colonelblacc/Automotive-BLE-CAN-Gateway/BOM/BOM_Automotive_BLE_CAN.csv

Item | Designator | Qty | Value | Description | Package | Manufacturer | MPN | Ratings / Tolerance | Automotive Qual | Alternatives | Notes / Design Intent
1 | AE1 | 1 | Antenna_Chip | 2.45 GHz Ceramic Chip Antenna, Peak Gain 1.5 dBi, 50 Ohm | Johanson_2450AT18x100_2400-2500Mhz | Johanson Technology | 2450AT18D0100E |  | AEC-Q200 qualified option | Pulse W3008, Taoglas GLA.01 | Compact Bluetooth Low Energy omnidirectional antenna
2 | C1 | 1 | 2.2uF | 2.2uF Ceramic Capacitor, Decoupling | C_0603_1608Metric | Murata / TDK / Taiyo Yuden | GCM188R71E2.2K | 16V / 25V, X7R, ±10% | AEC-Q200 Grade 1
3 | C2 | 1 | 2.2nF | 2.2nF Ceramic Capacitor, Precision / High-Q | C_0603_1608Metric | Murata / TDK / Taiyo Yuden | GCM1885C1H2.2nFA01D | 50V, C0G/NP0 (RF) or X7R, ±5% | AEC-Q200 Grade 1
4 | C3, C53 | 2 | 22uF | 22uF Ceramic Capacitor, High Capacitance Low ESR | C_0603_1608Metric | Murata / TDK / Taiyo Yuden | GCM21BR71E226KA73L | 25V / 50V, X7R / X7S, ±10% | AEC-Q200 Grade 1
5 | C4, C30, C31, C34, C37, C46, C50, C52 | 8 | 100nF | 100nF Ceramic Capacitor, Precision / High-Q | C_0603_1608Metric | Murata / TDK / Taiyo Yuden | GCM1885C1H100nFA01D | 50V, C0G/NP0 (RF) or X7R, ±5% | AEC-Q200 Grade 1
6 | C5, C6, C7, C8, C9, C10, C11, C16 | 8 | 0.1uF | 0.1uF Ceramic Capacitor, Decoupling | C_0603_1608Metric | Murata / TDK / Taiyo Yuden | GCM188R71E0.1K | 16V / 25V, X7R, ±10% | AEC-Q200 Grade 1
7 | C12 | 1 | 10uF | 10uF Ceramic Capacitor, High Capacitance Low ESR | C_0603_1608Metric | Murata / TDK / Taiyo Yuden | GCM21BR71E106KA73L | 25V / 50V, X7R / X7S, ±10% | AEC-Q200 Grade 1
8 | C13, C33, C42, C43, C45, C51 | 6 | 1uF | 1uF Ceramic Capacitor, Decoupling | C_0603_1608Metric | Murata / TDK / Taiyo Yuden | GCM188R71E1K | 16V / 25V, X7R, ±10% | AEC-Q200 Grade 1
9 | C14, C17 | 2 | 12pF | 12pF Ceramic Capacitor, Precision / High-Q | C_0402_1005Metric | Murata / TDK / Taiyo Yuden | GCM1555C1H12pFA01D | 50V, C0G/NP0 (RF) or X7R, ±5% | AEC-Q200 Grade 1
10 | C15 | 1 | 10pF | 10pF Ceramic Capacitor, Precision / High-Q | C_0402_1005Metric | Murata / TDK / Taiyo Yuden | GCM1555C1H10pFA01D | 50V, C0G/NP0 (RF) or X7R, ±5% | AEC-Q200 Grade 1
11 | C18, C20 | 2 | 15pF | 15pF Ceramic Capacitor, Precision / High-Q | C_0402_1005Metric | Murata / TDK / Taiyo Yuden | GCM1555C1H15pFA01D | 50V, C0G/NP0 (RF) or X7R, ±5% | AEC-Q200 Grade 1
12 | C19 | 1 | 1.2pF | 1.2pF Ceramic Capacitor, Precision / High-Q | C_0402_1005Metric | Murata / TDK / Taiyo Yuden | GCM1555C1H1.2pFA01D | 50V, C0G/NP0 (RF) or X7R, ±5% | AEC-Q200 Grade 1
13 | C21 | 1 | 0.7pF | 0.7pF Ceramic Capacitor, Precision / High-Q | C_0402_1005Metric | Murata / TDK / Taiyo Yuden | GCM1555C1H0.7pFA01D | 50V, C0G/NP0 (RF) or X7R, ±5% | AEC-Q200 Grade 1
14 | C22, C23 | 2 | 1.5pF | 1.5pF Ceramic Capacitor, Precision / High-Q | C_0402_1005Metric | Murata / TDK / Taiyo Yuden | GCM1555C1H1.5pFA01D | 50V, C0G/NP0 (RF) or X7R, ±5% | AEC-Q200 Grade 1
15 | C24 | 1 | 100nF | 100nF Ceramic Capacitor, Precision / High-Q | C_0402_1005Metric | Murata / TDK / Taiyo Yuden | GCM1555C1H100nFA01D | 50V, C0G/NP0 (RF) or X7R, ±5% | AEC-Q200 Grade 1
16 | C25 | 1 | 330nF | 330nF Ceramic Capacitor, Precision / High-Q | C_0603_1608Metric | Murata / TDK / Taiyo Yuden | GCM1885C1H330nFA01D | 50V, C0G/NP0 (RF) or X7R, ±5% | AEC-Q200 Grade 1
17 | C27, C28 | 2 | 8.2pF | 8.2pF Ceramic Capacitor, Precision / High-Q | C_0402_1005Metric | Murata / TDK / Taiyo Yuden | GCM1555C1H8.2pFA01D | 50V, C0G/NP0 (RF) or X7R, ±5% | AEC-Q200 Grade 1
18 | C29 | 1 | 10uF | 10uF Ceramic Capacitor, High Capacitance Low ESR | C_1210_3225Metric | Murata / TDK / Taiyo Yuden | GCM21BR71E106KA73L | 25V / 50V, X7R / X7S, ±10% | AEC-Q200 Grade 1
19 | C32 | 1 | 4.7nF | 4.7nF Ceramic Capacitor, Precision / High-Q | C_0603_1608Metric | Murata / TDK / Taiyo Yuden | GCM1885C1H4.7nFA01D | 50V, C0G/NP0 (RF) or X7R, ±5% | AEC-Q200 Grade 1
20 | C35, C40 | 2 | 22uF | 22uF Ceramic Capacitor, High Capacitance Low ESR | C_0805_2012Metric | Murata / TDK / Taiyo Yuden | GCM21BR71E226KA73L | 25V / 50V, X7R / X7S, ±10% | AEC-Q200 Grade 1
21 | C36, C49 | 2 | 2.2uF | 2.2uF Ceramic Capacitor, Decoupling | C_0805_2012Metric | Murata / TDK / Taiyo Yuden | GCM188R71E2.2K | 16V / 25V, X7R, ±10% | AEC-Q200 Grade 1
22 | C38, C39 | 2 | 4.7uF | 4.7uF Ceramic Capacitor, Decoupling | C_0805_2012Metric | Murata / TDK / Taiyo Yuden | GCM188R71E4.7K | 16V / 25V, X7R, ±10% | AEC-Q200 Grade 1
23 | C26, C41, C44 | 3 | 10uF | 10uF Ceramic Capacitor, High Capacitance Low ESR | C_0805_2012Metric | Murata / TDK / Taiyo Yuden | GCM21BR71E106KA73L | 25V / 50V, X7R / X7S, ±10% | AEC-Q200 Grade 1
24 | C47 | 1 | 1.0nF | 1.0nF Ceramic Capacitor, Precision / High-Q | C_0603_1608Metric | Murata / TDK / Taiyo Yuden | GCM1885C1H1.0nFA01D | 50V, C0G/NP0 (RF) or X7R, ±5% | AEC-Q200 Grade 1
25 | C48 | 1 | 100pF | 100pF Ceramic Capacitor, Precision / High-Q | C_0402_1005Metric | Murata / TDK / Taiyo Yuden | GCM1555C1H100pFA01D | 50V, C0G/NP0 (RF) or X7R, ±5% | AEC-Q200 Grade 1
26 | D1 | 1 | D_TVS | 36V Bidirectional Automotive TVS Diode, 400W Peak Pulse Power | D_SMC | Bourns / Littelfuse | SMAJ36CA |  | AEC-Q101, ISO 7637-2 / ISO 16750-2 | TPSMAJ36CA | Primary vehicle input transient & load-dump surge protection
27 | D2 | 1 | 15V | 15V 500mW Zener Diode | D_SOD-123 | Diodes Inc | BZT52C15-7-F |  | AEC-Q101 | MMSZ5245B | P-FET gate clamp protection against over-voltage
28 | D3 | 1 | D_TVS | 70V 70mA Dual Schottky Barrier Diode | D_0402_1005Metric | Vishay | BAS70-04 |  | AEC-Q101 | BAT54S | Fast clamp steering diode
29 | D4 | 1 | LED | 70V 70mA Dual Schottky Barrier Diode | LED_0603_1608Metric | Vishay | BAS70-04 |  | AEC-Q101 | BAT54S | Fast clamp steering diode
30 | D5 | 1 | D_TVS_Dual_AAC | Automotive Dual Bidirectional Transil ESD Protection for CAN bus | SOT-23 | STMicroelectronics | ESDCAN24-2BWY |  | AEC-Q101, ISO 10605 (±30kV air/contact) | NUP2105L, PESD2CAN | Protects TCAN4550 CANH/CANL pins against ESD & automotive spikes
31 | F1 | 1 | 2A (provisional) | 2.0A, 125V Fast-Acting Surface Mount Fuse | Fuse_1206_3216Metric | Littelfuse | 0451002.MRL |  | AEC-Q200 | 0154002.DR, CC12H2A | Vehicle input catastrophic overcurrent fuse
32 | FL1 | 1 | Filter_EMI_CommonMode | Automotive Common-Mode Choke 51uH for CAN-Bus / CAN FD | L_CommonModeChoke_Coilcraft_1812CAN | TDK | ACT45B-510-2P-TL003 |  | AEC-Q200 Grade 1 | DLW43SH510XK2L | Filters common-mode RF noise and emissions on CAN bus (CISPR 25)
33 | J1, J2 | 2 | Conn_01x03_Pin | 3-pin 3.5mm Automotive Screw Terminal (VIN, GND, IGN) | PinHeader_1x03_P2.54mm_Vertical | Phoenix Contact / JST / Wurth | Phoenix Contact 1984620 (PT 1.5/3-3.5-H) |  | Automotive / High Temp UL94V-0
34 | J3 | 1 | Conn_01x05_Pin | 5-pin Micro SWD Debug & Programming Header (1.27mm) | PinHeader_1x05_P2.54mm_Vertical | Phoenix Contact / JST / Wurth | Samtec FTSH-105-01-L-DV |  | Automotive / High Temp UL94V-0
35 | J_BAT1 | 1 | Conn_01x03_Pin | 2-pin JST-PH 2.0mm Shrouded Battery Connector | JST_PH_B3B-PH-K_1x03_P2.00mm_Vertical | Phoenix Contact / JST / Wurth | JST S2B-PH-K-S |  | Automotive / High Temp UL94V-0
36 | JP1 | 1 | Conn_01x02_Pin | 2-pin 2.54mm Header with Jumper Shunt (120 Ohm CAN Termination) | PinHeader_1x02_P2.54mm_Vertical | Harwin / Samtec | M20-9990245 |  | AEC-Q200 / Industrial
37 | L1 | 1 | 47uH | 22uH Shielded Power Inductor for LM5164 Buck | L_Bourns_SRN6045TA | Coilcraft / TDK / Würth | XAL5030-223MEB (22uH, 2.1A) | High Saturation Current, Shielded | AEC-Q200 Grade 1
38 | L2 | 1 | 10uH | 10uH Power Inductor / RF Choke | L_0805_2012Metric | Coilcraft / TDK / Würth | LQW15AN10uH | High Saturation Current, Shielded | AEC-Q200 Grade 1
39 | L3 | 1 | 2nH | 2nH Power Inductor / RF Choke | L_0402_1005Metric | Coilcraft / TDK / Würth | LQW15AN2nH | High Saturation Current, Shielded | AEC-Q200 Grade 1
40 | L4 | 1 | 2.8nH | 2.8nH Power Inductor / RF Choke | L_0402_1005Metric | Coilcraft / TDK / Würth | LQW15AN2.8nH | High Saturation Current, Shielded | AEC-Q200 Grade 1
41 | L6 | 1 | 2.2uH | 2.2uH Shielded Power Inductor for TPS63900 Buck-Boost | L_1008_2520Metric | Coilcraft / TDK / Würth | XFL4020-222MEB (2.2uH, 3.5A) | High Saturation Current, Shielded | AEC-Q200 Grade 1
42 | L5, L8 | 2 | 6.8uH | 4.7uH Shielded Power Inductor for LMR36506 Buck | L_Coilcraft_XxL4020 | Coilcraft / TDK / Würth | LPS4018-472MRB (4.7uH, 1.8A) | High Saturation Current, Shielded | AEC-Q200 Grade 1
43 | Q1 | 1 | SQ2361AEES-T1_GE3 | -60V, -2.1A P-Channel TrenchFET Power MOSFET | SOT-23 | Vishay Siliconix | SQ2361AEES-T1_GE3 |  | AEC-Q101 Grade 1 (-55 to 175C) | DMP6023L, SI2319CDS | Low-loss reverse battery polarity protection
44 | R3 | 1 | 174k | 174k Thick Film Precision Resistor | R_0603_1608Metric | Vishay / Yageo / Panasonic | CRCW0603174kFKTA | 1/10W, 1%, ±100ppm/°C | AEC-Q200 Grade 1
45 | R6 | 1 | 20.0k | 20.0k Thick Film Precision Resistor | R_0603_1608Metric | Vishay / Yageo / Panasonic | CRCW060320R0kFKTA | 1/10W, 1%, ±100ppm/°C | AEC-Q200 Grade 1
46 | R1, R2, R4, R5, R7 | 5 | 100k | 100k Thick Film Precision Resistor | R_0603_1608Metric | Vishay / Yageo / Panasonic | CRCW0603100kFKTA | 1/10W, 1%, ±100ppm/°C | AEC-Q200 Grade 1
47 | R11, R12 | 2 | 60.4 | 60.4 Thick Film Precision Resistor | R_0805_2012Metric | Vishay / Yageo / Panasonic | CRCW040260R4FKED | 1/10W, 1%, ±100ppm/°C | AEC-Q200 Grade 1
48 | R13, R14 | 2 | 1M | 1M Thick Film Precision Resistor | R_0603_1608Metric | Vishay / Yageo / Panasonic | CRCW06031MFKTA | 1/10W, 1%, ±100ppm/°C | AEC-Q200 Grade 1
49 | R15 | 1 | 2.16k | 2.16k Thick Film Precision Resistor | R_0603_1608Metric | Vishay / Yageo / Panasonic | CRCW06032R16kFKTA | 1/10W, 1%, ±100ppm/°C | AEC-Q200 Grade 1
50 | R16 | 1 | 2k | 2k Thick Film Precision Resistor | R_0603_1608Metric | Vishay / Yageo / Panasonic | CRCW06032kFKTA | 1/10W, 1%, ±100ppm/°C | AEC-Q200 Grade 1
51 | R17 | 1 | 16.2k | 16.2k Thick Film Precision Resistor | R_0603_1608Metric | Vishay / Yageo / Panasonic | CRCW060316R2kFKTA | 1/10W, 1%, ±100ppm/°C | AEC-Q200 Grade 1
52 | R18 | 1 | 511 | 511 Thick Film Precision Resistor | R_0603_1608Metric | Vishay / Yageo / Panasonic | CRCW0603511FKTA | 1/10W, 1%, ±100ppm/°C | AEC-Q200 Grade 1
53 | R19 | 1 | 36.5k | 36.5k Thick Film Precision Resistor | R_0603_1608Metric | Vishay / Yageo / Panasonic | CRCW060336R5kFKTA | 1/10W, 1%, ±100ppm/°C | AEC-Q200 Grade 1
54 | R20 | 1 | 9.53k | 9.53k Thick Film Precision Resistor | R_0603_1608Metric | Vishay / Yageo / Panasonic | CRCW06039R53kFKTA | 1/10W, 1%, ±100ppm/°C | AEC-Q200 Grade 1
55 | R21 | 1 | 5k | 5k Thick Film Precision Resistor | R_0603_1608Metric | Vishay / Yageo / Panasonic | CRCW06035kFKTA | 1/10W, 1%, ±100ppm/°C | AEC-Q200 Grade 1
56 | R22, R25 | 2 | 1k | 1k Thick Film Precision Resistor | R_0603_1608Metric | Vishay / Yageo / Panasonic | CRCW06031kFKTA | 1/10W, 1%, ±100ppm/°C | AEC-Q200 Grade 1
57 | R23 | 1 | 110k | 110k Thick Film Precision Resistor | R_0603_1608Metric | Vishay / Yageo / Panasonic | CRCW0603110kFKTA | 1/10W, 1%, ±100ppm/°C | AEC-Q200 Grade 1
58 | R8, R9, R10, R24 | 4 | 10k | 10k Thick Film Precision Resistor | R_0603_1608Metric | Vishay / Yageo / Panasonic | CRCW060310kFKTA | 1/10W, 1%, ±100ppm/°C | AEC-Q200 Grade 1
59 | R26 | 1 | 402k | 402k Thick Film Precision Resistor | R_0603_1608Metric | Vishay / Yageo / Panasonic | CRCW0603402kFKTA | 1/10W, 1%, ±100ppm/°C | AEC-Q200 Grade 1
60 | R27 | 1 | 20k | 20k Thick Film Precision Resistor | R_0805_2012Metric | Vishay / Yageo / Panasonic | CRCW040220kFKED | 1/10W, 1%, ±100ppm/°C | AEC-Q200 Grade 1
61 | R28 | 1 | 100k | 100k Thick Film Precision Resistor | R_0805_2012Metric | Vishay / Yageo / Panasonic | CRCW0402100kFKED | 1/10W, 1%, ±100ppm/°C | AEC-Q200 Grade 1
62 | TP1, TP2, TP3, TP4, TP5, TP6, TP7, TP8, TP9 | 9 | TestPoint | SMD Test Point Pad (TestPoint) | TestPoint_Pad_D2.0mm | Keystone Electronics | 5015 / 5019 | Gold Plated | RoHS / Commercial
63 | U1 | 1 | LM5164DDA | 100V, 1A Synchronous COT Step-Down Converter | HSOP-8-1EP_3.9x4.9mm_P1.27mm_EP2.41x3.1mm_ThermalVias | Texas Instruments | LM5164DDAR |  | AEC-Q100 Grade 1 | LMR16006, TPS54160 | Primary vehicle buck 9-36V to 3.3V
64 | U2 | 1 | CC2340R52E0RKPR | SimpleLink Multiprotocol 2.4 GHz BLE 5.3 Wireless MCU, 512KB Flash, Cortex-M0+ | RKP0040B-MFG | Texas Instruments | CC2340R40RKPR |  | AEC-Q100 (CC2340R5-Q1) | NRF52840, EFR32BG22 | Main BLE communication & system controller
65 | U3 | 1 | TCAN4550RGY | Automotive CAN FD Controller with Integrated Transceiver, SPI Interface | Texas_RGY_R-PVQFN-N20_EP2.05x3.05mm | Texas Instruments | TCAN4550RGYRQ1 |  | AEC-Q100 Grade 1 | TCAN4551-Q1, MCP2518FD | ISO 11898-2:2016 CAN FD physical layer & protocol engine
66 | U4 | 1 | LMR36506MSC5RPERQ1 | 65V, 0.6A Synchronous Step-Down Buck Converter (5V Output) | RPE0009A | Texas Instruments | LMR36506MSC5RPERQ1 |  | AEC-Q100 Grade 1 | LMR33610-Q1 | Secondary buck for CAN transceiver & charger
67 | U5 | 1 | BQ24040DSQR | 1A Single-Input, Single-Cell Li-Ion Battery Charger with NTC & Power Good | DSQ10_P9X1P5 | Texas Instruments | BQ24040DSQR |  | Standard Industrial (-40 to 125C) | MCP73831, BQ24090 | Backup Li-Ion cell charging from 5V rail
68 | U6 | 1 | TPS63900 | High-Efficiency 1.8V-5.5V, 400mA Buck-Boost Converter with Dynamic Voltage Scaling | WSON-10-1EP_2.5x2.5mm_P0.5mm_EP1.2x2mm_ThermalVias | Texas Instruments | TPS63900DSKR |  | Standard Industrial (-40 to 125C) | ISL9120, TPS63000 | Regulates 3.0-4.2V battery to constant 3.3V backup
69 | U7 | 1 | TPS2116DRLR | Low-IQ, 1.6V to 5.5V, 2.5A Dual-Input Power Multiplexer with Auto-Switchover | DRL0008A-MFG | Texas Instruments | TPS2116DRLR |  | Standard Industrial (-40 to 125C) | TPS2113A, TPS2121 | Seamless auto-switch between vehicle 3.3V and battery 3.3V
70 | U8 | 1 | LMR36506MSCQRPERQ1 | 65V, 0.6A Synchronous Step-Down Buck Converter (5V Output) | RPE0009A | Texas Instruments | LMR36506MSC5RPERQ1 |  | AEC-Q100 Grade 1 | LMR33610-Q1 | Dedicated 5V power supply rail
71 | Y1 | 1 | 48MHz | 48.000 MHz SMD Crystal, 8pF, ±10ppm | Crystal_SMD_2016-4Pin_2.0x1.6mm | NDK | NX2016SA-48M-STD-CSZ-1 |  | AEC-Q200 Grade 1 | Abracon ABM11W-48.0000MHZ | CC2340 48 MHz main system & RF oscillator
72 | Y2 | 1 | 32.768Khz | 32.768 kHz Tuning Fork Crystal, 12.5pF, ±20ppm | Crystal_SMD_3215-2Pin_3.2x1.5mm | Abracon | AB26T-32.768KHZ |  | AEC-Q200 | Citizen CMR200T | Real-Time Clock / low-power sleep timer
73 | Y3 | 1 | 40MHz | 40.000 MHz Automotive SMD Crystal, 10pF, ±30ppm | Crystal_SMD_3225-4Pin_3.2x2.5mm | Epson | FA-238 40.0000MB-C3 |  | AEC-Q200 Grade 1 | TXC 7A-40.000MAAJ-T | TCAN4550 CAN FD bit-rate generator clock source
