colonelblacc/Automotive-BLE-CAN-Gateway/Step Files/Automotive_BLE_CAN.step

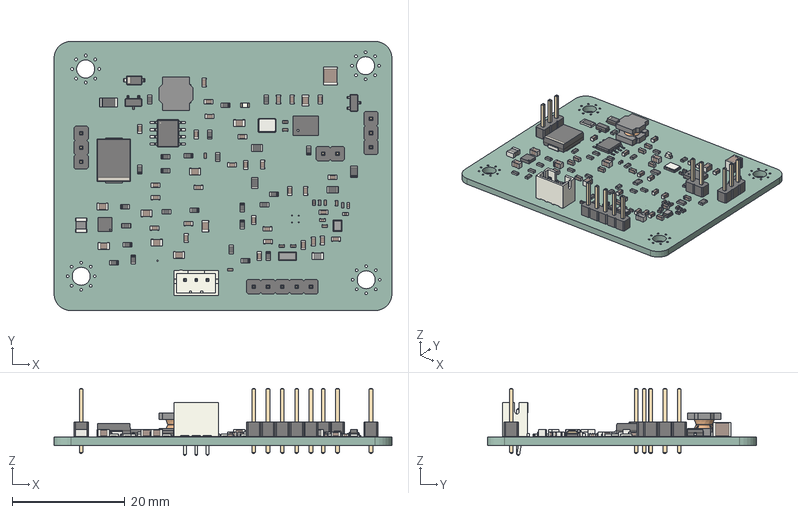
[picture p15: CAD file, 2026-10-16]
Step Files/Automotive_BLE_CAN.step
59.9 x 47.8 x 11.9 mm
HSOP-8-1EP_3.9x4.9mm_P1.27mm_EP2.41x3.1mm
C_0603_1608Metric x 30
C_0402_1005Metric x 13
C_0805_2012Metric x 9
R_0603_1608Metric x 24
D_SOD-123
Crystal_SMD_3225-4Pin_3.2x2.5mm
7a0a93aa-926b-11ed-8620-a0cec80452fd_part
7a0a9878-926b-11ed-8620-a0cec80452fd_part
7a0a9b48-926b-11ed-8620-a0cec80452fd_part
7a0a9db4-926b-11ed-8620-a0cec80452fd_part
R_0805_2012Metric x 4
Crystal_SMD_3215-2Pin_3.2x1.5mm
43e594cd-ed20-11ed-b06b-f76ff2fea4fd_part
43e594ce-ed20-11ed-b06b-f76ff2fea4fd_part
43e594cf-ed20-11ed-b06b-f76ff2fea4fd_part
JST_B3B_PH_K
PinHeader_1x03_P254mm_Vertical x 2
SOT-23 x 2
PinHeader_1x05_P254mm_Vertical
Crystal_SMD_2016-4Pin_2.0x1.6mm
L_0402_1005Metric x 2
L_Bourns_SRN6045TA
C_1210_3225Metric
L_1008_2520Metric
L_0805_2012Metric
Fuse_1206_3216Metric
LED_0603_1608Metric
PinHeader_1x02_P254mm_Vertical
D_SMC
ByteBeam_BLE_CAN_PCB
