colonelblacc/Automotive-BLE-CAN-Gateway/Result Images/3D-View Back.png

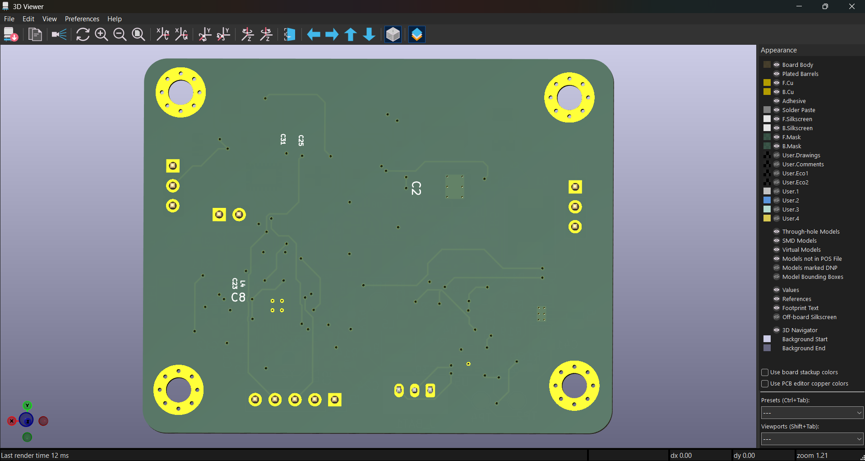
Result Images/3D-View Back.png
