colonelblacc/Automotive-BLE-CAN-Gateway/Result Images/3D-View Front.png

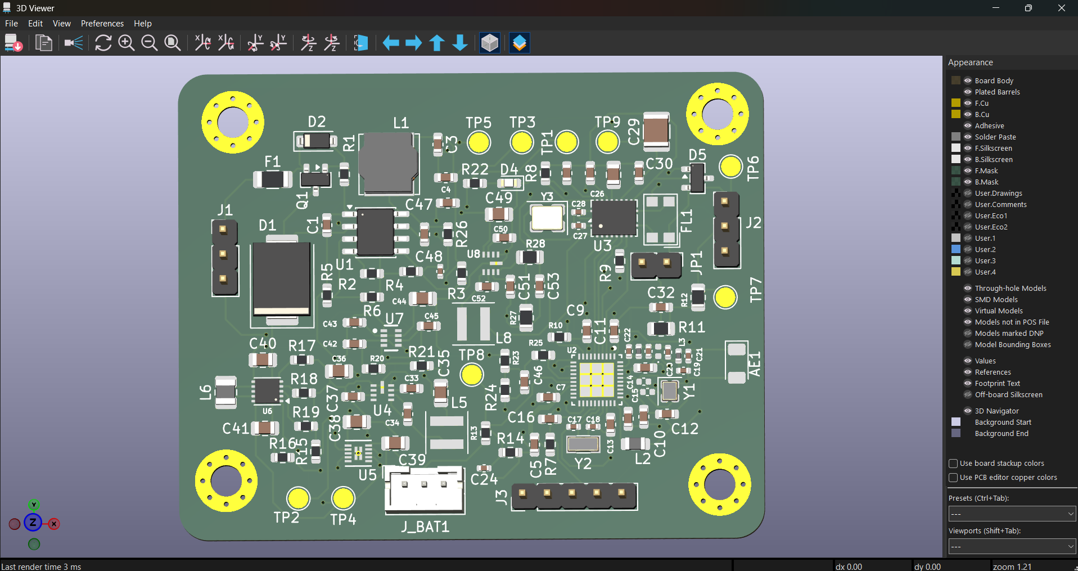
Result Images/3D-View Front.png
