colonelblacc/Automotive-BLE-CAN-Gateway/Result Images/PCB.png

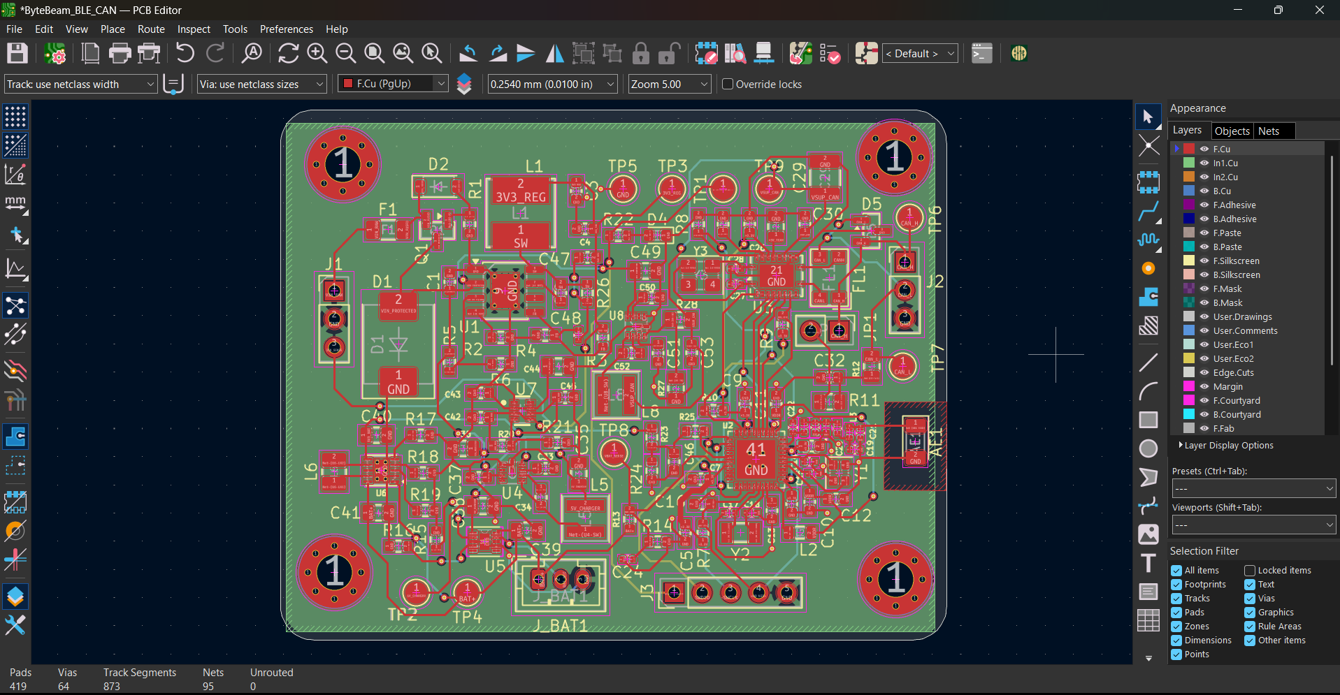
Result Images/PCB.png
