colonelblacc/Automotive-BLE-CAN-Gateway/Architecture Diagram/Automotive_BLE_CAN_Architecture_Diagram.pdf

# Automotive BLE-to-CAN Hardware Gateway KICAD 10 · 4-LAYER

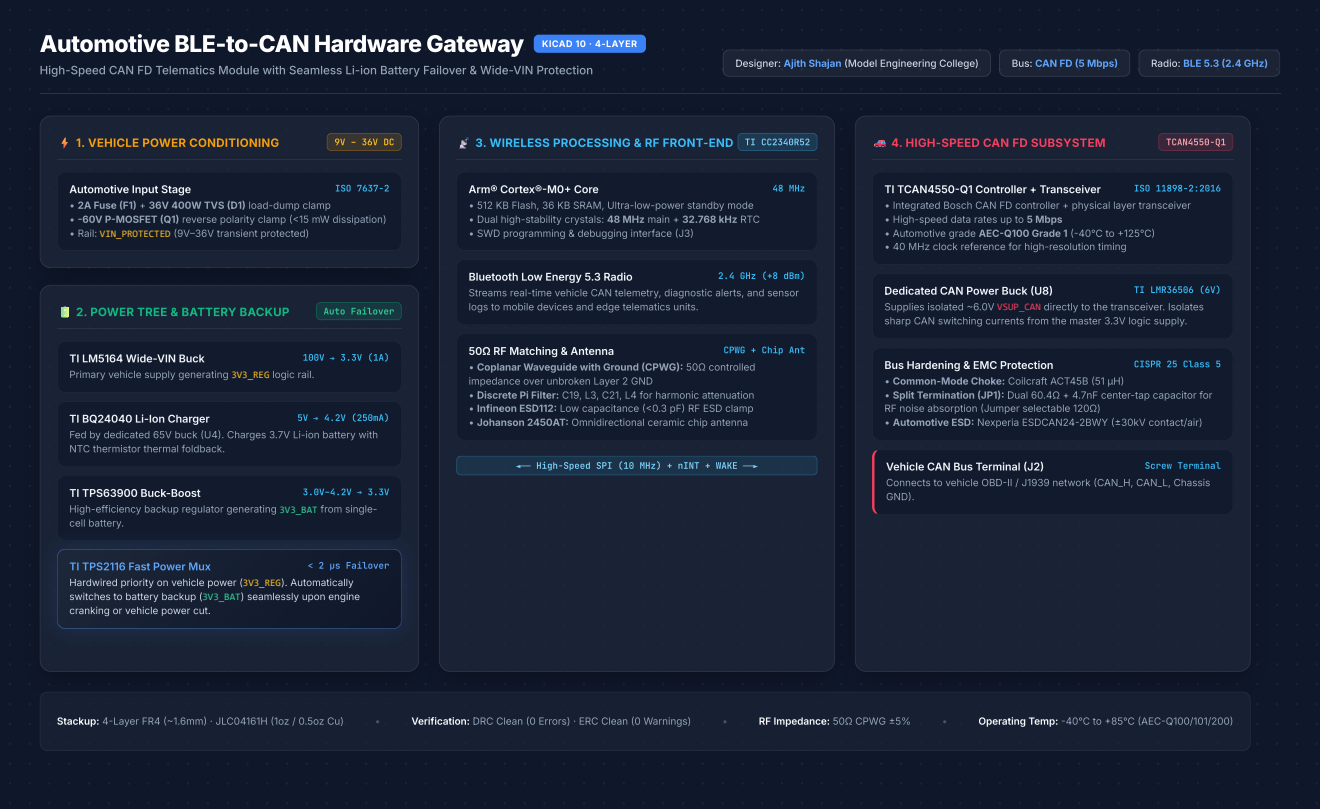
[picture p19: page 1]
Designer: Ajith Shajan (Model Engineering College); Bus: CAN FD (5 Mbps); Radio: BLE 5.3 (2.4 GHz); Stackup: 4-Layer FR4 (~1.6mm) · JLC04161H (1oz / 0.5oz Cu); Verification: DRC Clean (0 Errors) · ERC Clean (0 Warnings); RF Impedance: 50Ω CPWG ±5%; Operating Temp: -40°C to +85°C (AEC-Q100/101/200); ⚡ 1. VEHICLE POWER CONDITIONING; Automotive Input Stage; ISO 7637-2; 🔋 2. POWER TREE & BATTERY BACKUP; Auto Failover; TI LM5164 Wide-VIN Buck; TI BQ24040 Li-Ion Charger; TI TPS63900 Buck-Boost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

High-Speed CAN FD Telematics Module with Seamless Li-ion Battery Failover & Wide-VIN Protection

• 2A Fuse (F1) + 36V 400W TVS (D1) load-dump clamp
• -60V P-MOSFET (Q1) reverse polarity clamp (<15 mW dissipation)
• Rail: VIN_PROTECTED (9V–36V transient protected)

• 512 KB Flash, 36 KB SRAM, Ultra-low-power standby mode
• Dual high-stability crystals: 48 MHz main + 32.768 kHz RTC
• SWD programming & debugging interface (J3)

• Integrated Bosch CAN FD controller + physical layer transceiver
• High-speed data rates up to 5 Mbps
• Automotive grade AEC-Q100 Grade 1 (-40°C to +125°C)
• 40 MHz clock reference for high-resolution timing

Streams real-time vehicle CAN telemetry, diagnostic alerts, and sensor
logs to mobile devices and edge telematics units.

Supplies isolated ~6.0V VSUP_CAN directly to the transceiver. Isolates
sharp CAN switching currents from the master 3.3V logic supply.

• Coplanar Waveguide with Ground (CPWG): 50Ω controlled
impedance over unbroken Layer 2 GND
• Discrete Pi Filter: C19, L3, C21, L4 for harmonic attenuation
• Infineon ESD112: Low capacitance (<0.3 pF) RF ESD clamp
• Johanson 2450AT: Omnidirectional ceramic chip antenna

Primary vehicle supply generating 3V3_REG logic rail.

• Common-Mode Choke: Coilcraft ACT45B (51 µH)
• Split Termination (JP1): Dual 60.4Ω + 4.7nF center-tap capacitor for
RF noise absorption (Jumper selectable 120Ω)
• Automotive ESD: Nexperia ESDCAN24-2BWY (±30kV contact/air)

Fed by dedicated 65V buck (U4). Charges 3.7V Li-ion battery with
NTC thermistor thermal foldback.

◄── High-Speed SPI (10 MHz) + nINT + WAKE ──►

Connects to vehicle OBD-II / J1939 network (CAN_H, CAN_L, Chassis
GND).

High-efficiency backup regulator generating 3V3_BAT from single-
cell battery.

Hardwired priority on vehicle power (3V3_REG). Automatically
switches to battery backup (3V3_BAT) seamlessly upon engine
cranking or vehicle power cut.
