colonelblacc/Automotive-BLE-CAN-Gateway/Schematics/Automotive_BLE_CAN.pdf

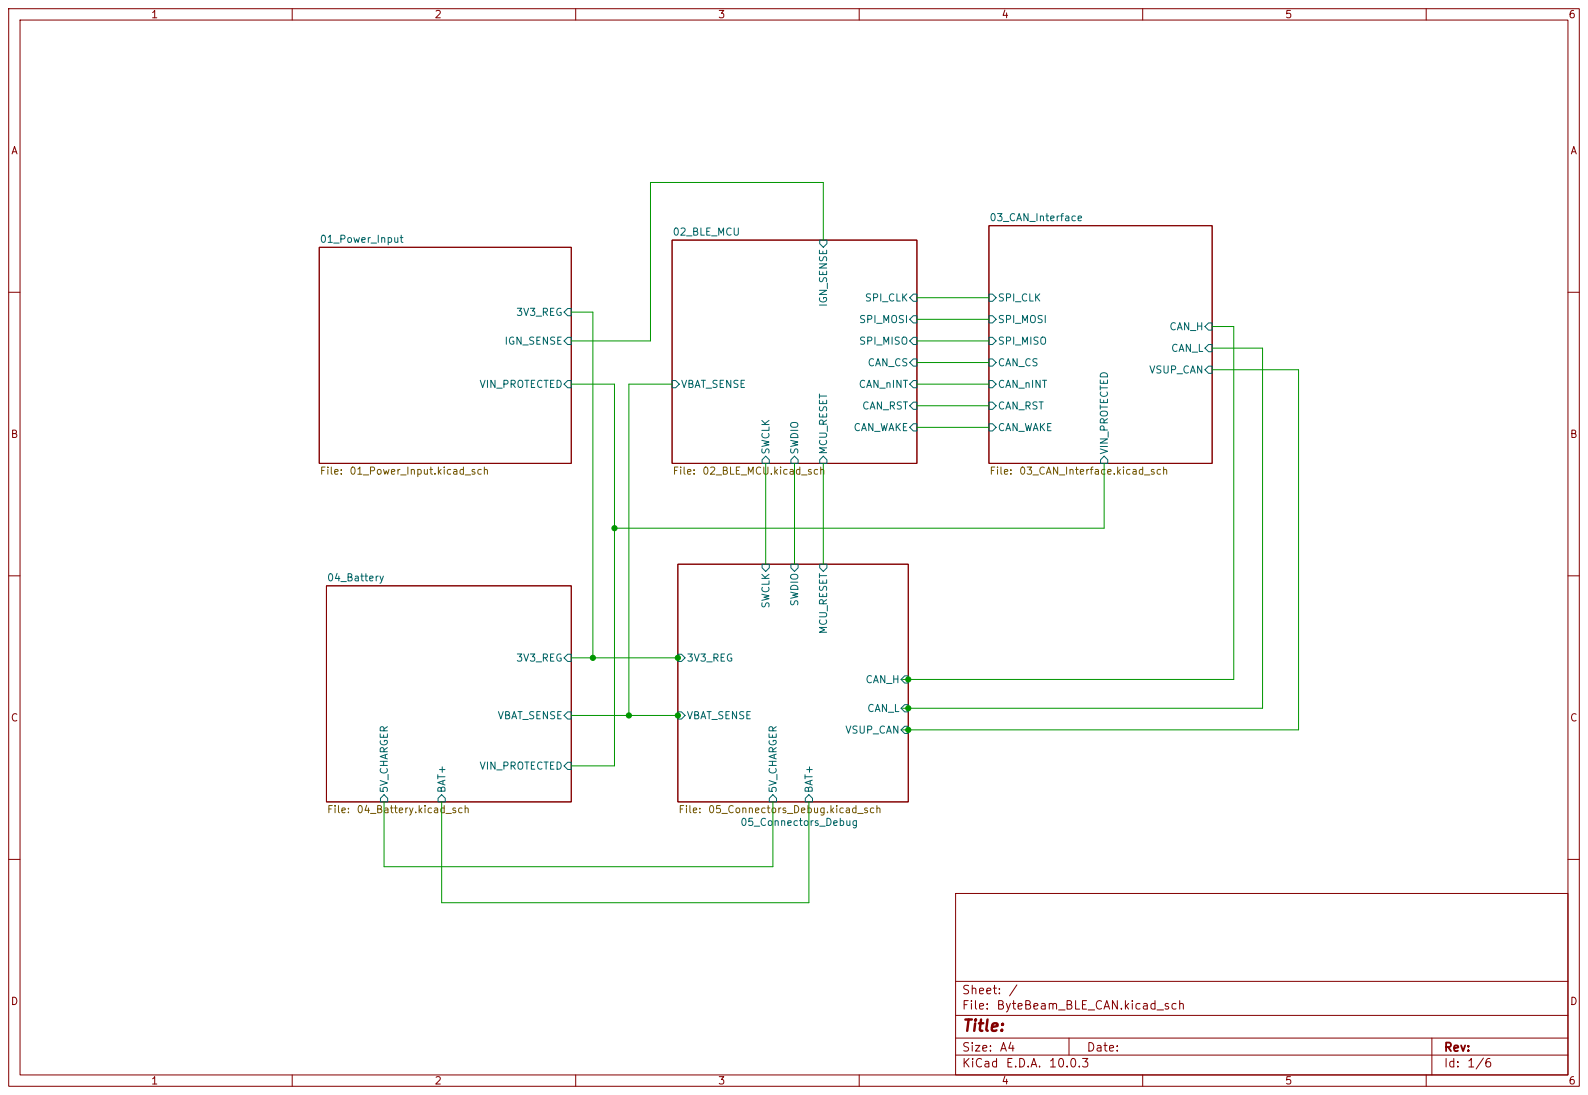
[picture p20: page 1]

Size: A4 | Rev:
KiCad E.D.A. 10.0.3 | Id: 1/6

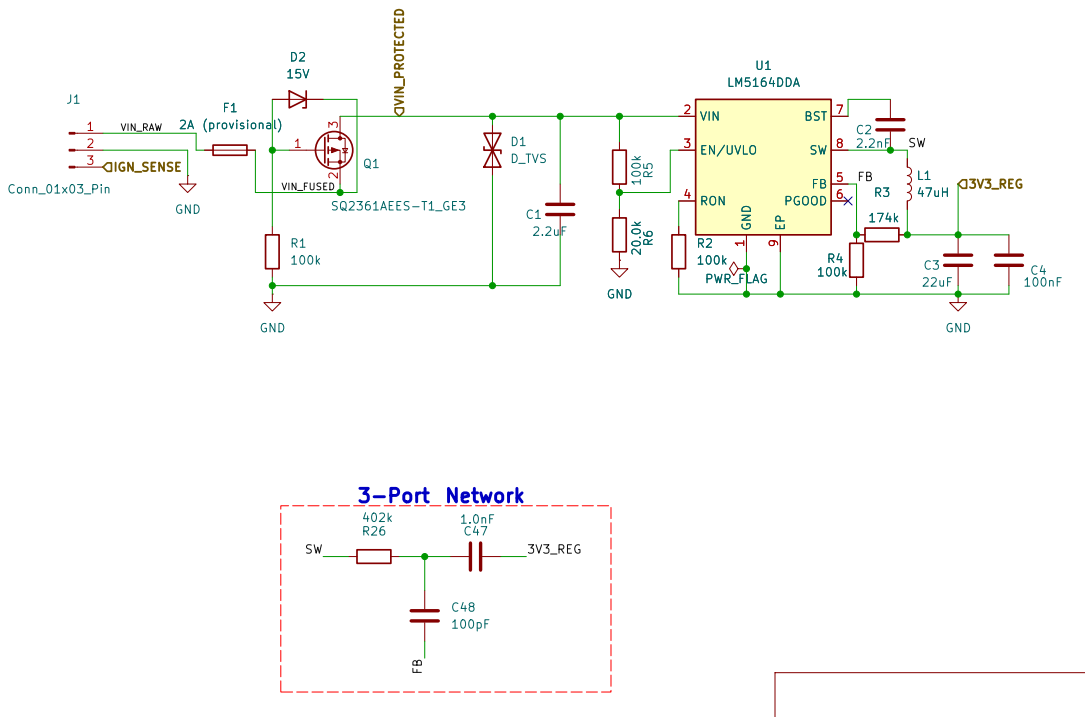
[picture p21: page 2]

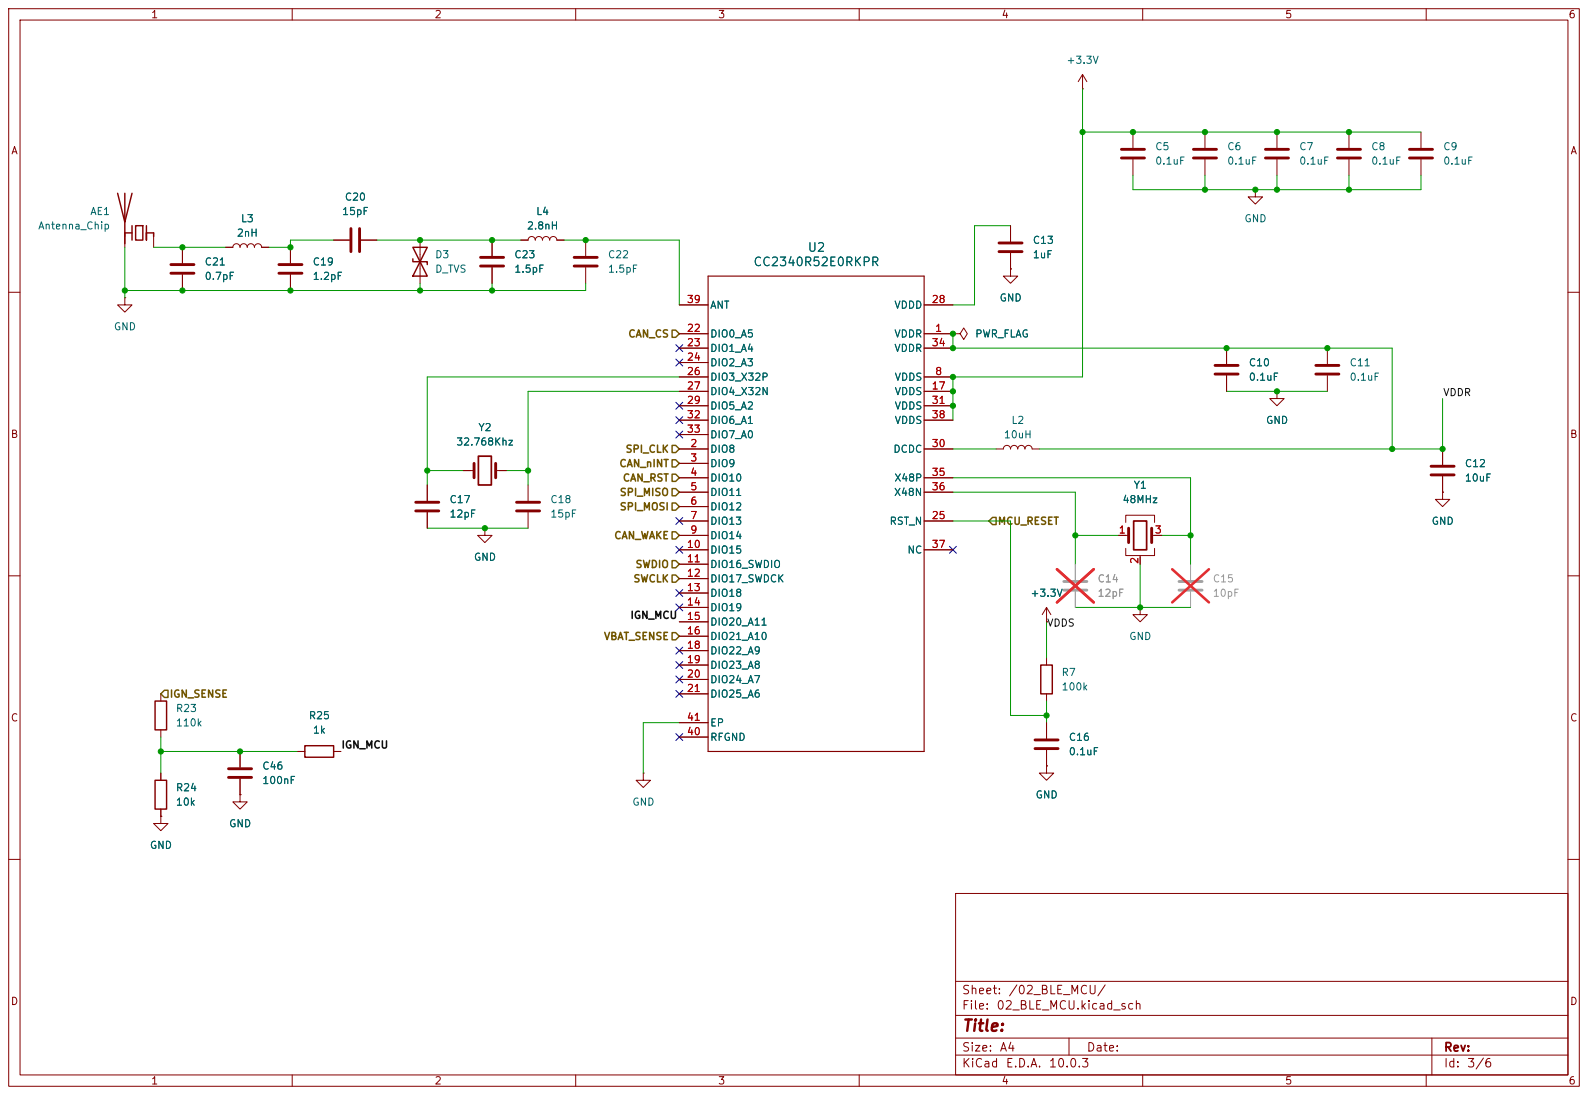
[picture p22: page 3]

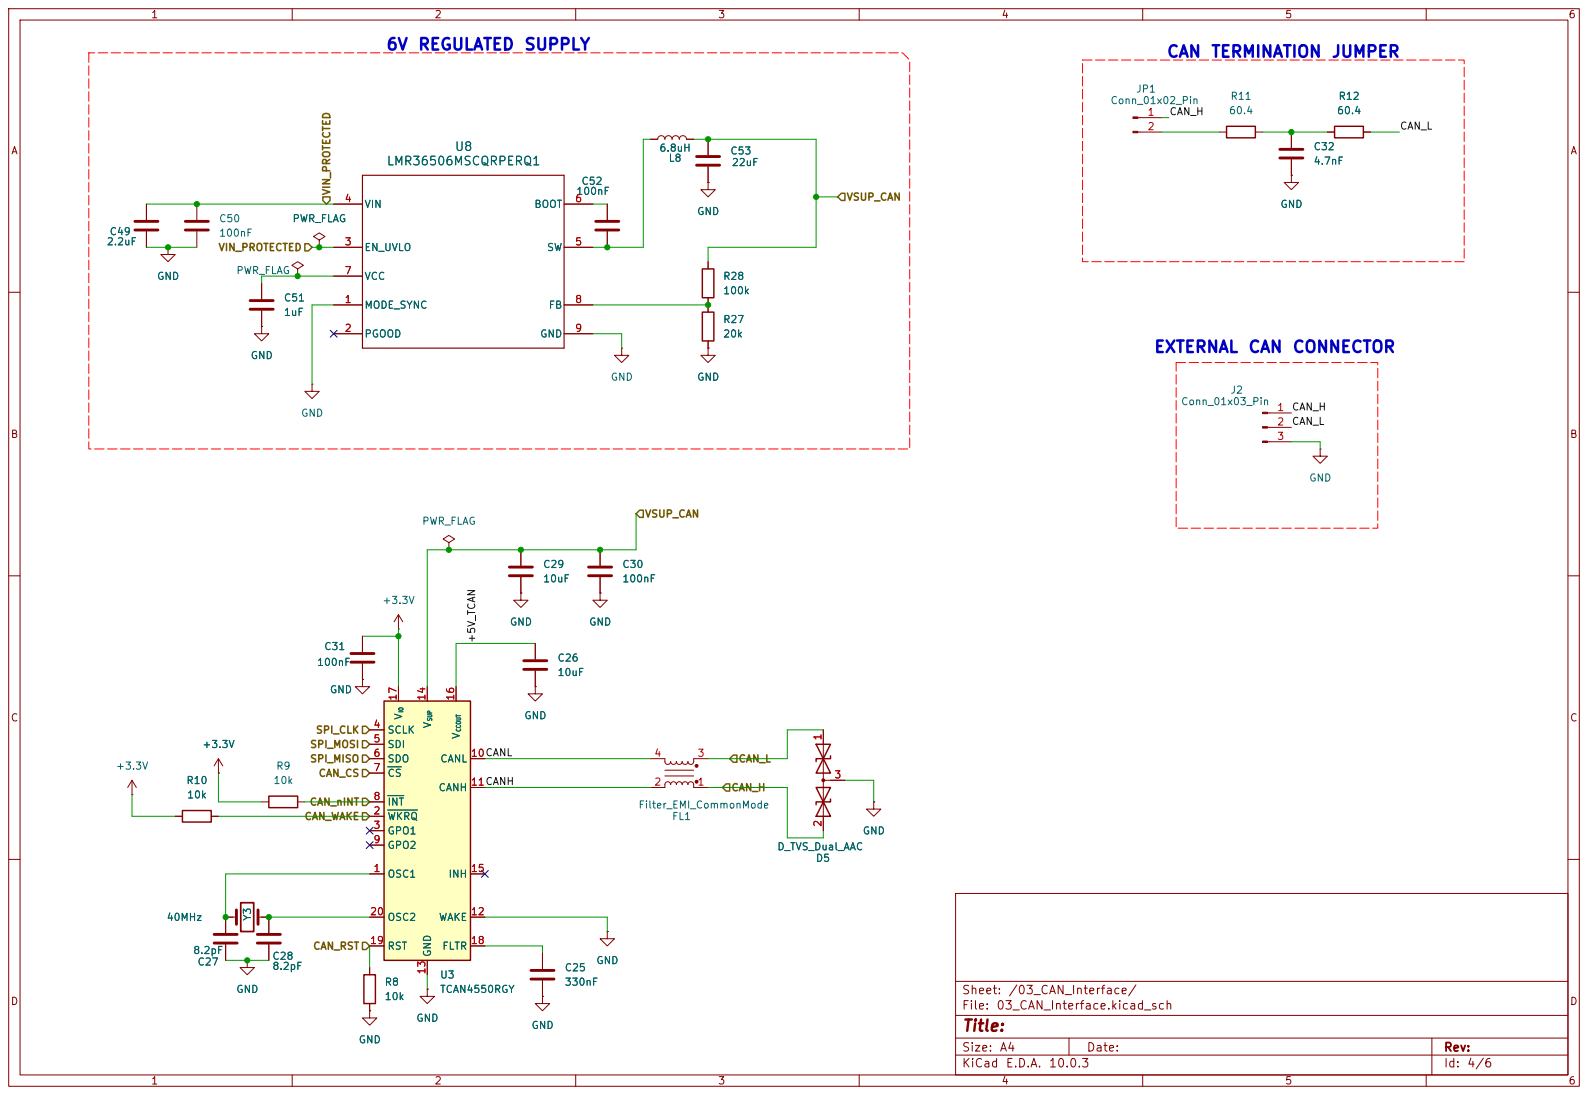
[picture p23: page 4]

CAN TERMINATION JUMPER 6V REGULATED SUPPLY

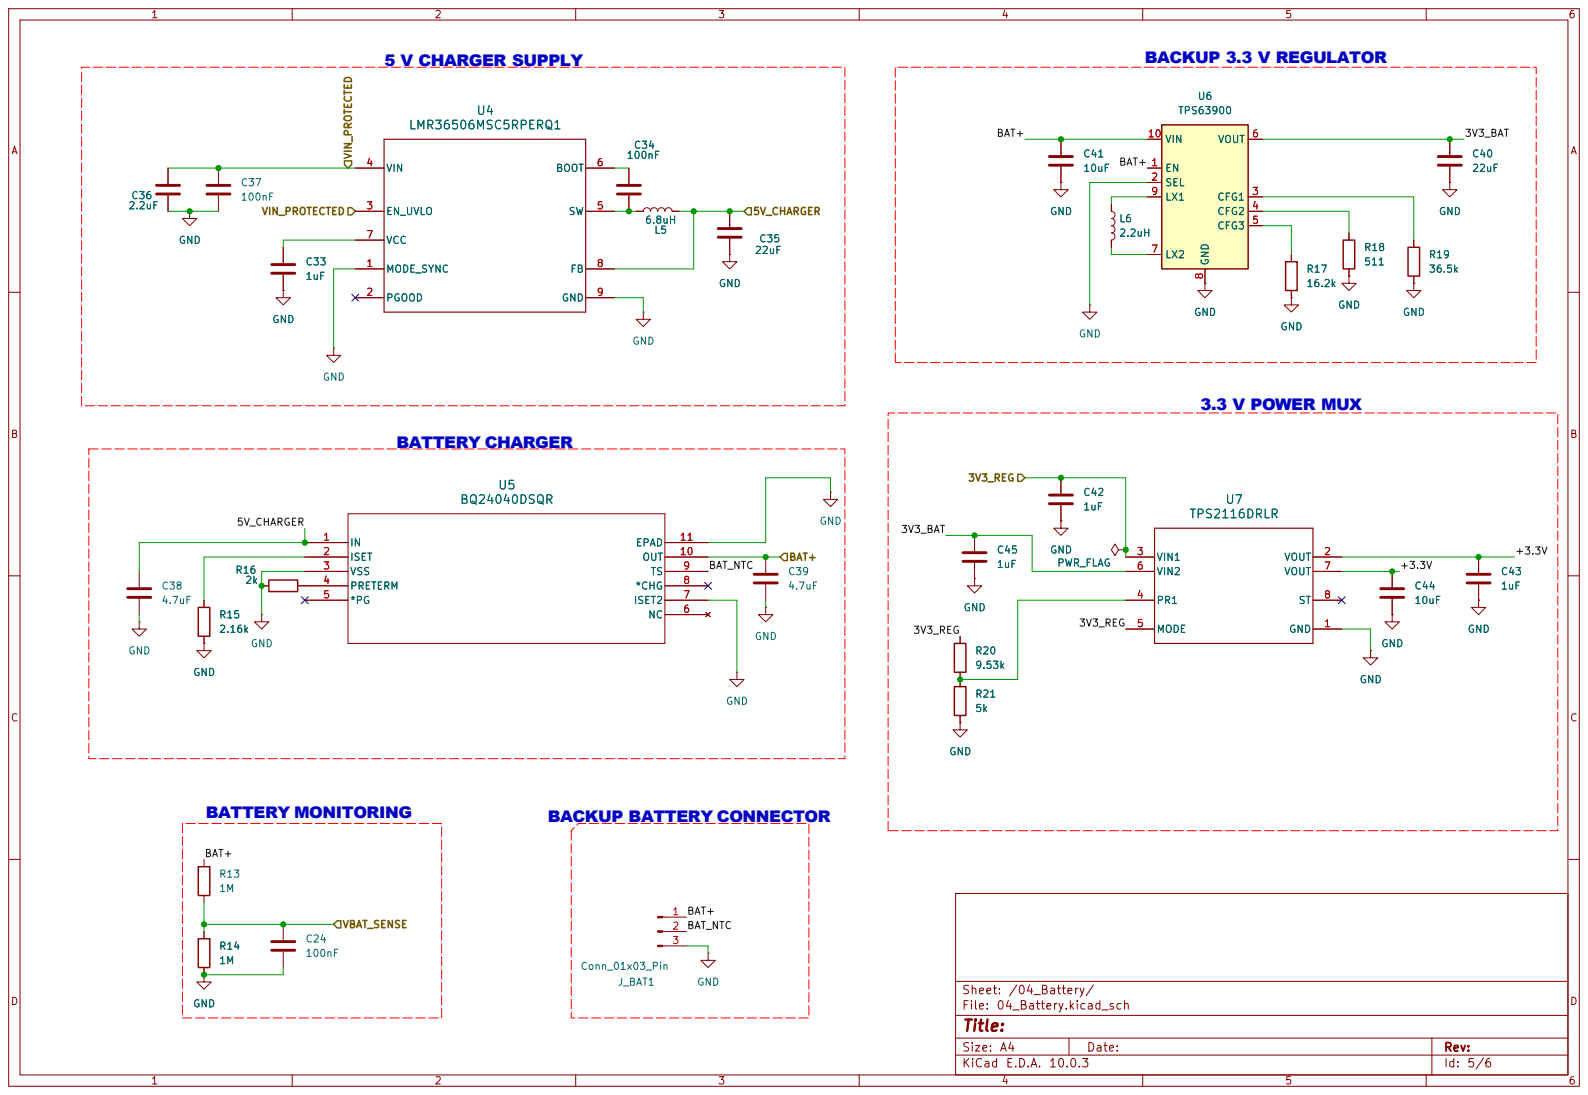
[picture p24: page 5]

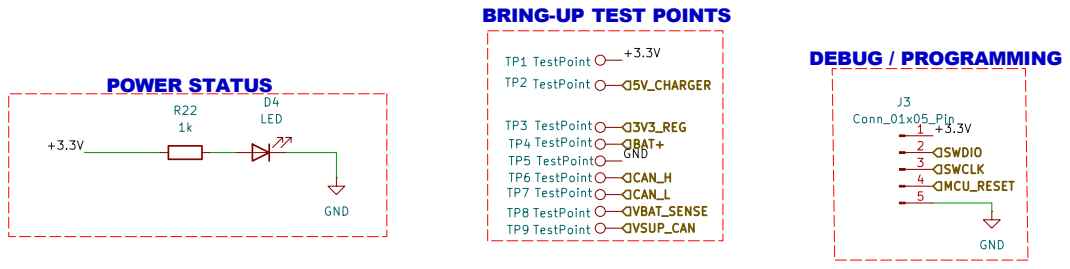
[picture p25: page 6]
