colonelblacc/Automotive-BLE-CAN-Gateway/Automotive_BLE_CAN.kicad_pcb

## KiCad design Automotive_BLE_CAN.kicad_pcb (2026-10-16)

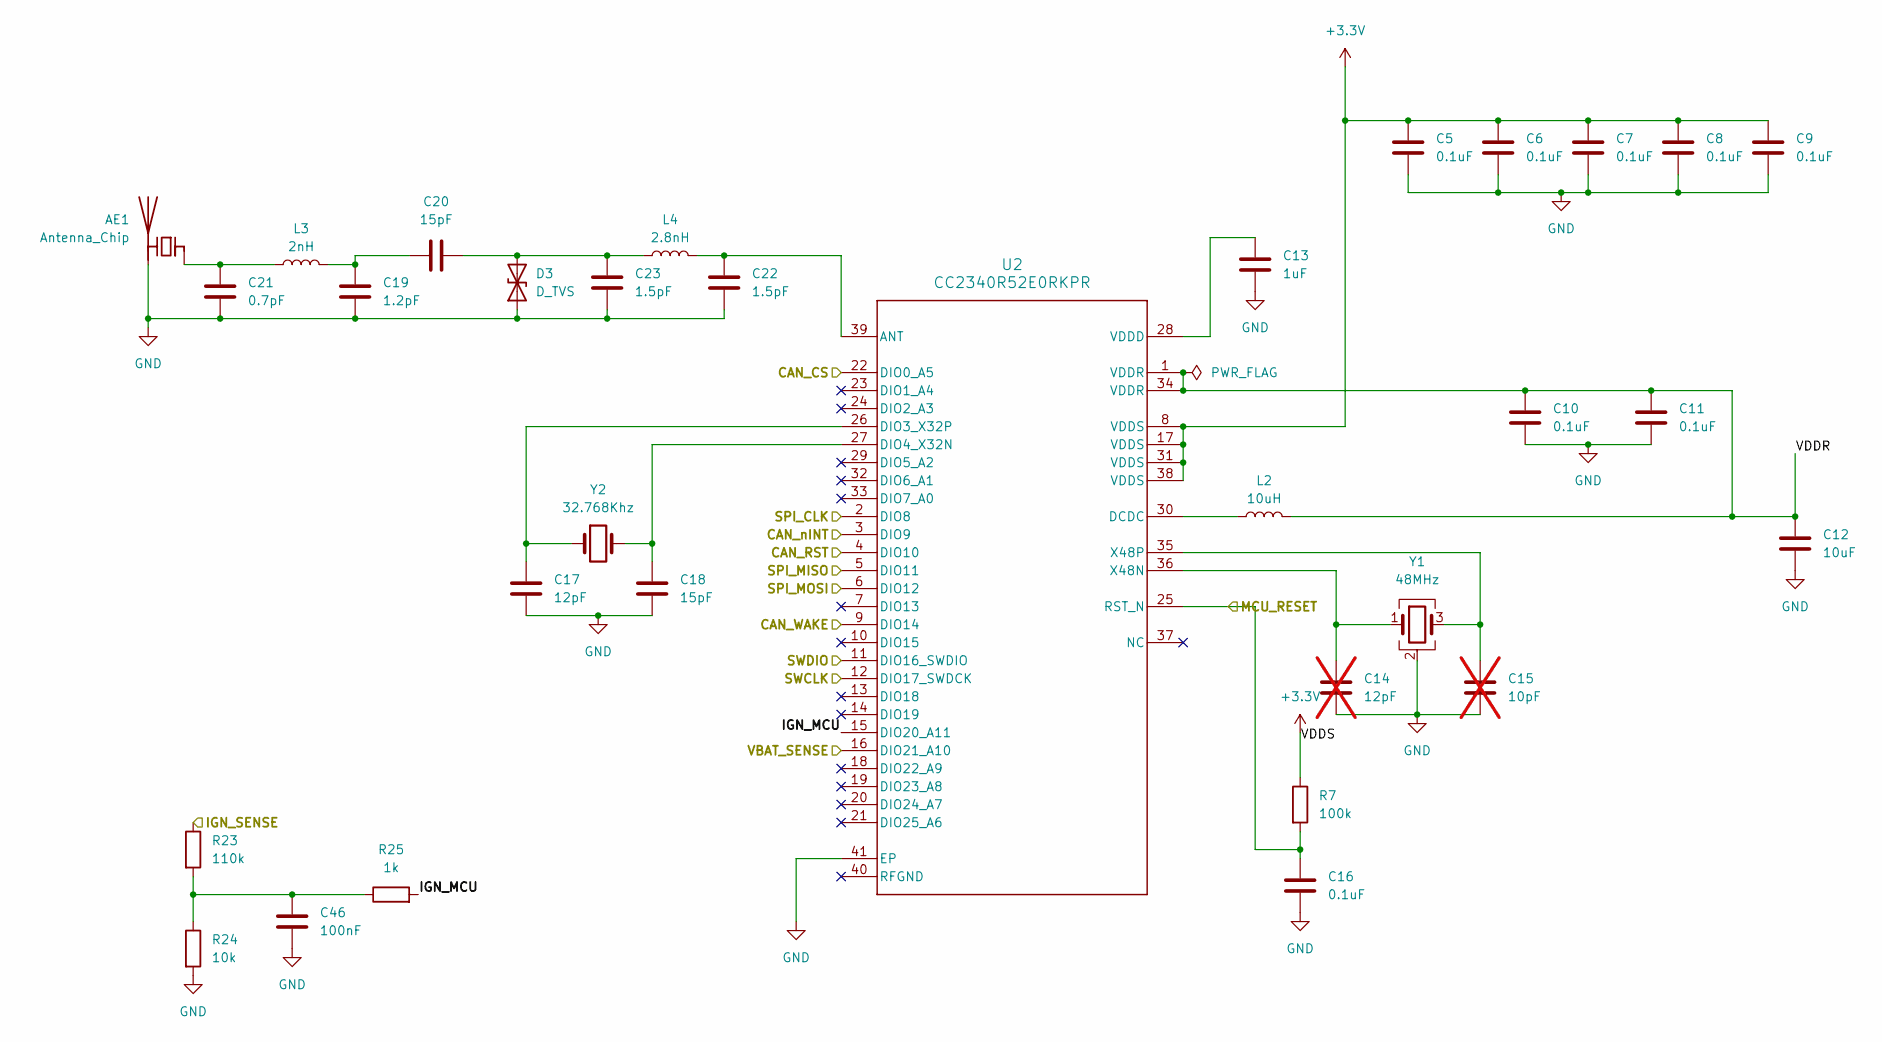
[picture p26: schematic 02_BLE_MCU.kicad_sch]

Parts:
AE1: Antenna_Chip; Johanson_2450AT18x100_2400-2500Mhz
C5, C6, C7, C8, C9, C10, C11, C16: 0.1uF; C_0603_1608Metric
C12: 10uF; C_0603_1608Metric
C13: 1uF; C_0603_1608Metric
C14: 12pF; C_0402_1005Metric; not fitted
C15: 10pF; C_0402_1005Metric; not fitted
C17: 12pF; C_0402_1005Metric
C18, C20: 15pF; C_0402_1005Metric
C19: 1.2pF; C_0402_1005Metric
C21: 0.7pF; C_0402_1005Metric
C22, C23: 1.5pF; C_0402_1005Metric
C46: 100nF; C_0603_1608Metric
D3: D_TVS; D_0402_1005Metric
L2: 10uH; L_0805_2012Metric
L3: 2nH; L_0402_1005Metric
L4: 2.8nH; L_0402_1005Metric
R7: 100k; R_0603_1608Metric
R23: 110k; R_0603_1608Metric
R24: 10k; R_0603_1608Metric
R25: 1k; R_0603_1608Metric
U2: CC2340R52E0RKPR; RKP0040B-MFG
Y1: 48MHz; Crystal_SMD_2016-4Pin_2.0x1.6mm
Y2: 32.768Khz; Crystal_SMD_3215-2Pin_3.2x1.5mm

Connections:
+3.3V: C5.1, C6.1, C7.1, C8.1, C9.1, R7.1, U2.8 (VDDS), U2.17 (VDDS), U2.31 (VDDS), U2.38 (VDDS); also elsewhere on the board
/01_Power_Input/IGN_SENSE: R23.1; also elsewhere on the board
/02_BLE_MCU/<NO NET>: C16.1, R7.2, U2.4 (DIO10), U2.25 (RST_N); also elsewhere on the board
/02_BLE_MCU/CAN_CS: U2.22 (DIO0_A5); also elsewhere on the board
/02_BLE_MCU/CAN_WAKE: U2.9 (DIO14); also elsewhere on the board
/02_BLE_MCU/CAN_nINT: U2.3 (DIO9); also elsewhere on the board
/02_BLE_MCU/IGN_MCU: R25.2, U2.15 (DIO20_A11)
/02_BLE_MCU/SPI_CLK: U2.2 (DIO8); also elsewhere on the board
/02_BLE_MCU/SPI_MISO: U2.5 (DIO11); also elsewhere on the board
/02_BLE_MCU/SPI_MOSI: U2.6 (DIO12); also elsewhere on the board
/02_BLE_MCU/SWCLK: U2.12 (DIO17_SWDCK); also elsewhere on the board
/02_BLE_MCU/SWDIO: U2.11 (DIO16_SWDIO); also elsewhere on the board
/02_BLE_MCU/VBAT_SENSE: U2.16 (DIO21_A10); also elsewhere on the board
/02_BLE_MCU/VDDR: C10.1, C11.1, C12.1, L2.2, U2.1 (VDDR), U2.34 (VDDR)
GND: AE1.2 (PCB_Trace), C5.2, C6.2, C7.2, C8.2, C9.2, C10.2, C11.2, C12.2, C13.2, C14.2, C15.2, C16.2, C17.2, C18.2, C19.2, C21.2, C22.2, C23.2, C46.2, D3.1 (A1), R24.2, U2.41 (EP), Y1.2 (G), Y1.4 (G); also elsewhere on the board
unnamed: AE1.1 (FEED), C21.1, L3.1
unnamed: C19.1, C20.1, L3.2
unnamed: C46.1, R23.2, R24.1, R25.1
unnamed: C20.2, C23.1, D3.2 (A2), L4.1
unnamed: C22.1, L4.2, U2.39 (ANT)
unnamed: L2.1, U2.30 (DCDC)
unnamed: C17.1, U2.26 (DIO3_X32P), Y2.1
unnamed: C18.1, U2.27 (DIO4_X32N), Y2.2
unnamed: C13.1, U2.28 (VDDD)
unnamed: C14.1, U2.36 (X48N), Y1.1
unnamed: C15.1, U2.35 (X48P), Y1.3

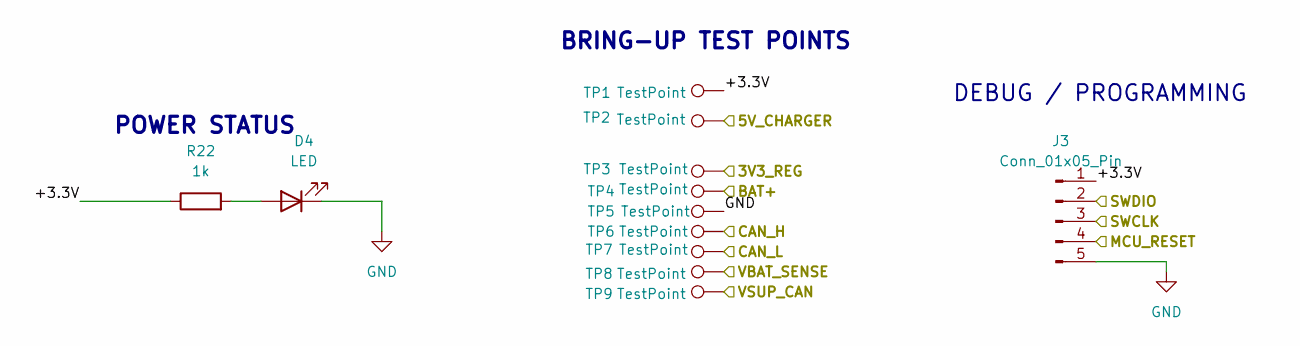
[picture p27: schematic 05_Connectors_Debug.kicad_sch]

Parts:
D4: LED; LED_0603_1608Metric
J3: Conn_01x05_Pin; PinHeader_1x05_P2.54mm_Vertical
R22: 1k; R_0603_1608Metric
TP1, TP2, TP3, TP4, TP5, TP6, TP7, TP8, TP9: TestPoint; TestPoint_Pad_D2.0mm

Connections:
/01_Power_Input/3V3_REG: TP3.1 (1_1); also elsewhere on the board
/02_BLE_MCU/<NO NET>: J3.4; also elsewhere on the board
/02_BLE_MCU/SWCLK: J3.3; also elsewhere on the board
/02_BLE_MCU/SWDIO: J3.2; also elsewhere on the board
/02_BLE_MCU/VBAT_SENSE: TP8.1 (1_1); also elsewhere on the board
/03_CAN_Interface/CAN_H: TP6.1 (1_1); also elsewhere on the board
/03_CAN_Interface/CAN_L: TP7.1 (1_1); also elsewhere on the board
/03_CAN_Interface/VSUP_CAN: TP9.1 (1_1); also elsewhere on the board
/04_Battery/5V_CHARGER: TP2.1 (1_1); also elsewhere on the board
/04_Battery/BAT+: TP4.1 (1_1); also elsewhere on the board
/05_Connectors_Debug/+3.3V: J3.1, R22.1, TP1.1 (1_1)
GND: D4.1 (K), J3.5, TP5.1 (1_1); also elsewhere on the board
unnamed: D4.2 (A), R22.2

Notes on the sheet:
DEBUG / PROGRAMMING
POWER STATUS
BRING-UP TEST POINTS

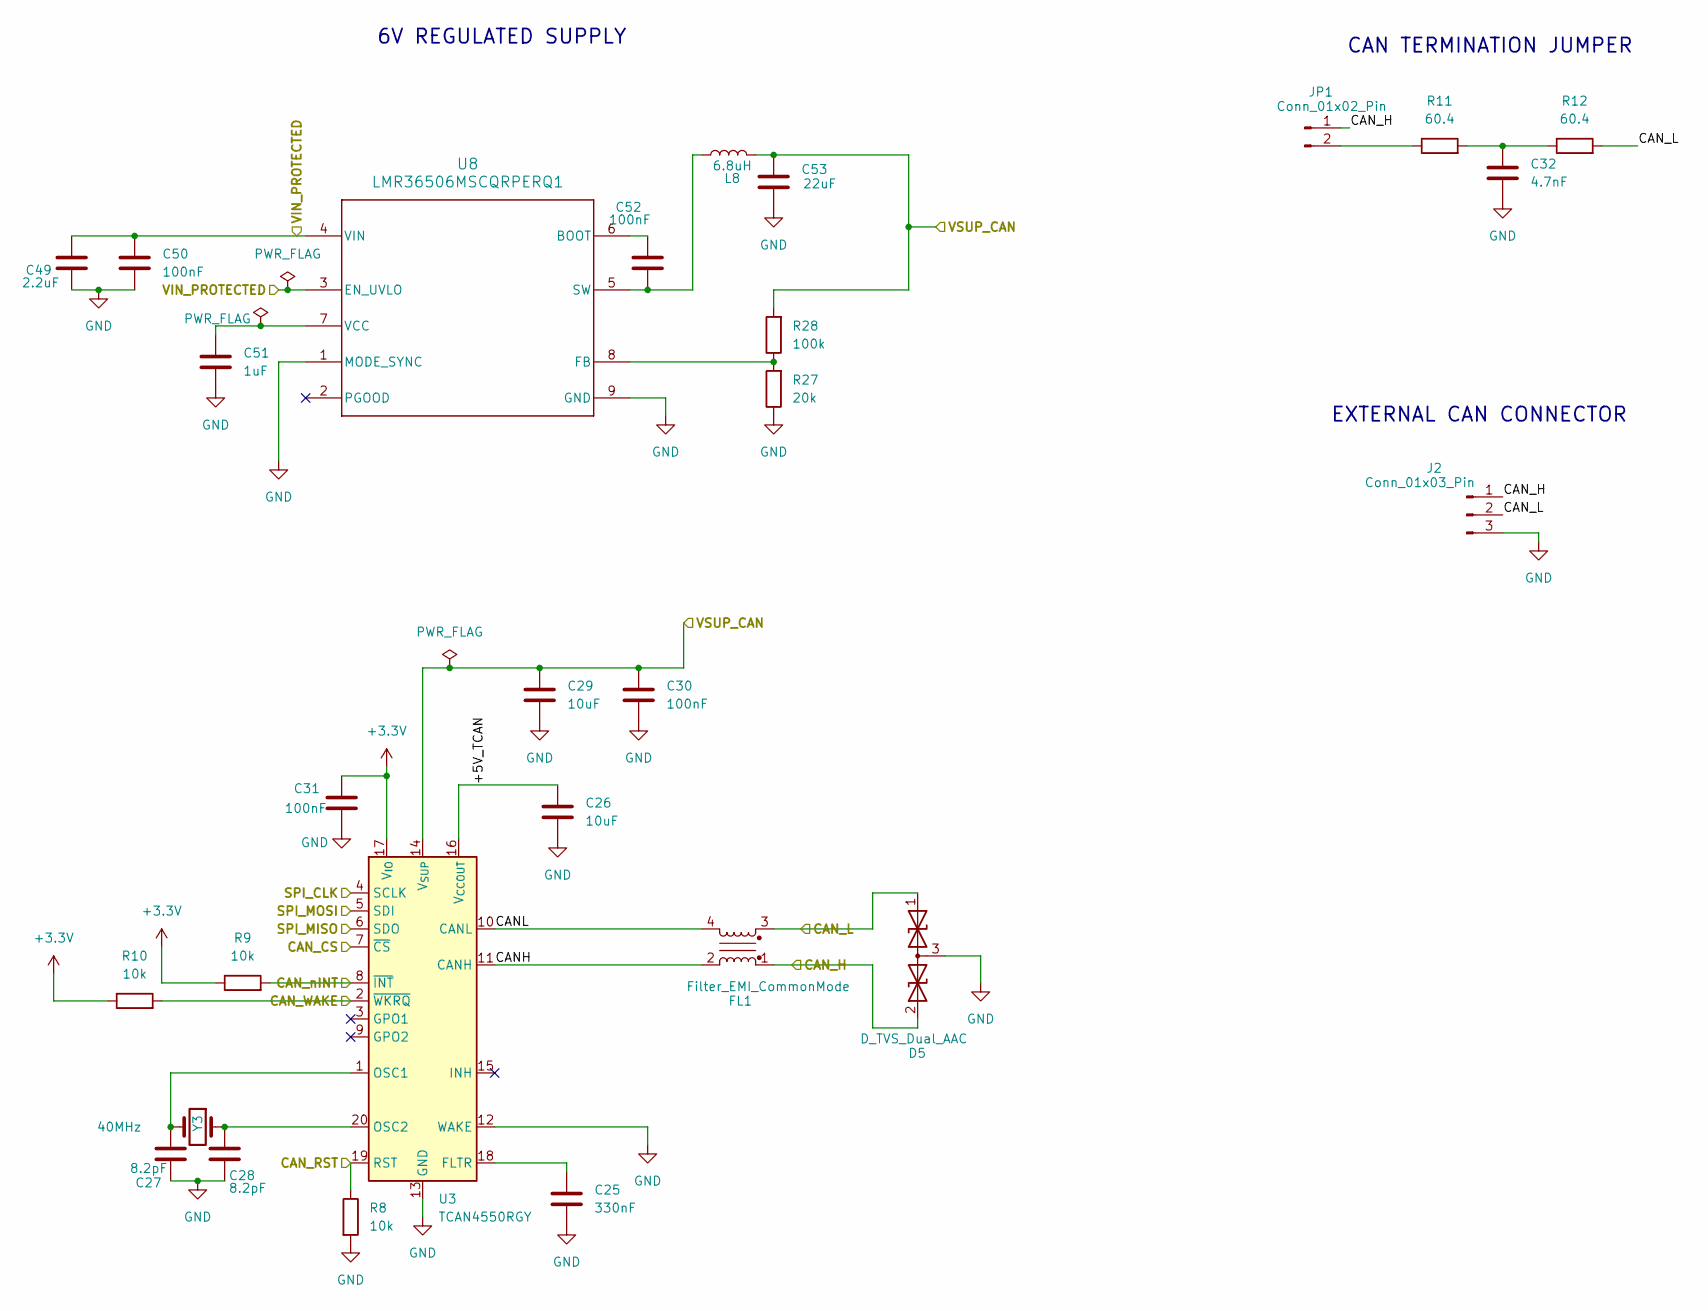
[picture p28: schematic 03_CAN_Interface.kicad_sch]

Parts:
C25: 330nF; C_0603_1608Metric
C26: 10uF; C_0805_2012Metric
C27, C28: 8.2pF; C_0402_1005Metric
C29: 10uF; C_1210_3225Metric
C30, C31, C50, C52: 100nF; C_0603_1608Metric
C32: 4.7nF; C_0603_1608Metric
C49: 2.2uF; C_0805_2012Metric
C51: 1uF; C_0603_1608Metric
C53: 22uF; C_0603_1608Metric
D5: D_TVS_Dual_AAC; SOT-23
FL1: Filter_EMI_CommonMode; L_CommonModeChoke_Coilcraft_1812CAN
J2: Conn_01x03_Pin; PinHeader_1x03_P2.54mm_Vertical
JP1: Conn_01x02_Pin; PinHeader_1x02_P2.54mm_Vertical
L8: 6.8uH; L_Coilcraft_XxL4020
R8, R9, R10: 10k; R_0603_1608Metric
R11, R12: 60.4; R_0805_2012Metric
R27: 20k; R_0805_2012Metric
R28: 100k; R_0805_2012Metric
U3: TCAN4550RGY; Texas_RGY_R-PVQFN-N20_EP2.05x3.05mm
U8: LMR36506MSCQRPERQ1; RPE0009A
Y3: 40MHz; Crystal_SMD_3225-4Pin_3.2x2.5mm

Connections:
+3.3V: C31.1, R9.1, R10.1, U3.17 (V_{IO}); also elsewhere on the board
/01_Power_Input/VIN_PROTECTED: C49.1, C50.1, U8.3 (EN_UVLO), U8.4 (VIN); also elsewhere on the board
/02_BLE_MCU/<NO NET>: R8.1, U3.19 (RST); also elsewhere on the board
/02_BLE_MCU/CAN_CS: U3.7 (~CS); also elsewhere on the board
/02_BLE_MCU/CAN_WAKE: R10.2, U3.2 (~WKRQ); also elsewhere on the board
/02_BLE_MCU/CAN_nINT: R9.2, U3.8 (~INT); also elsewhere on the board
/02_BLE_MCU/SPI_CLK: U3.4 (SCLK); also elsewhere on the board
/02_BLE_MCU/SPI_MISO: U3.6 (SDO); also elsewhere on the board
/02_BLE_MCU/SPI_MOSI: U3.5 (SDI); also elsewhere on the board
/03_CAN_Interface/+5V_TCAN: C26.1, U3.16 (V_{CCOUT})
/03_CAN_Interface/CANH: FL1.2, U3.11 (CANH)
/03_CAN_Interface/CANL: FL1.4, U3.10 (CANL)
/03_CAN_Interface/CAN_H: D5.2 (A2), FL1.1, J2.1, JP1.1; also elsewhere on the board
/03_CAN_Interface/CAN_L: D5.1 (A1), FL1.3, J2.2, R12.2; also elsewhere on the board
/03_CAN_Interface/VSUP_CAN: C29.1, C30.1, C53.1, L8.2, R28.2, U3.14 (V_{SUP}); also elsewhere on the board
GND: C25.2, C26.2, C27.2, C28.2, C29.2, C30.2, C31.2, C32.2, C49.2, C50.2, C51.2, C53.2, D5.3 (common), J2.3, R8.2, R27.1, U3.12 (WAKE), U3.13 (GND), U3.21 (GND), U8.1 (MODE_SYNC), U8.9 (GND); also elsewhere on the board
unnamed: C32.1, R11.2, R12.1
unnamed: JP1.2, R11.1
unnamed: C25.1, U3.18 (FLTR)
unnamed: C27.1, U3.1 (OSC1), Y3.2
unnamed: C28.1, U3.20 (OSC2), Y3.1
unnamed: C52.1, U8.6 (BOOT)
unnamed: R27.2, R28.1, U8.8 (FB)
unnamed: C52.2, L8.1, U8.5 (SW)
unnamed: C51.1, U8.7 (VCC)

Notes on the sheet:
CAN TERMINATION JUMPER
EXTERNAL CAN CONNECTOR
6V REGULATED SUPPLY

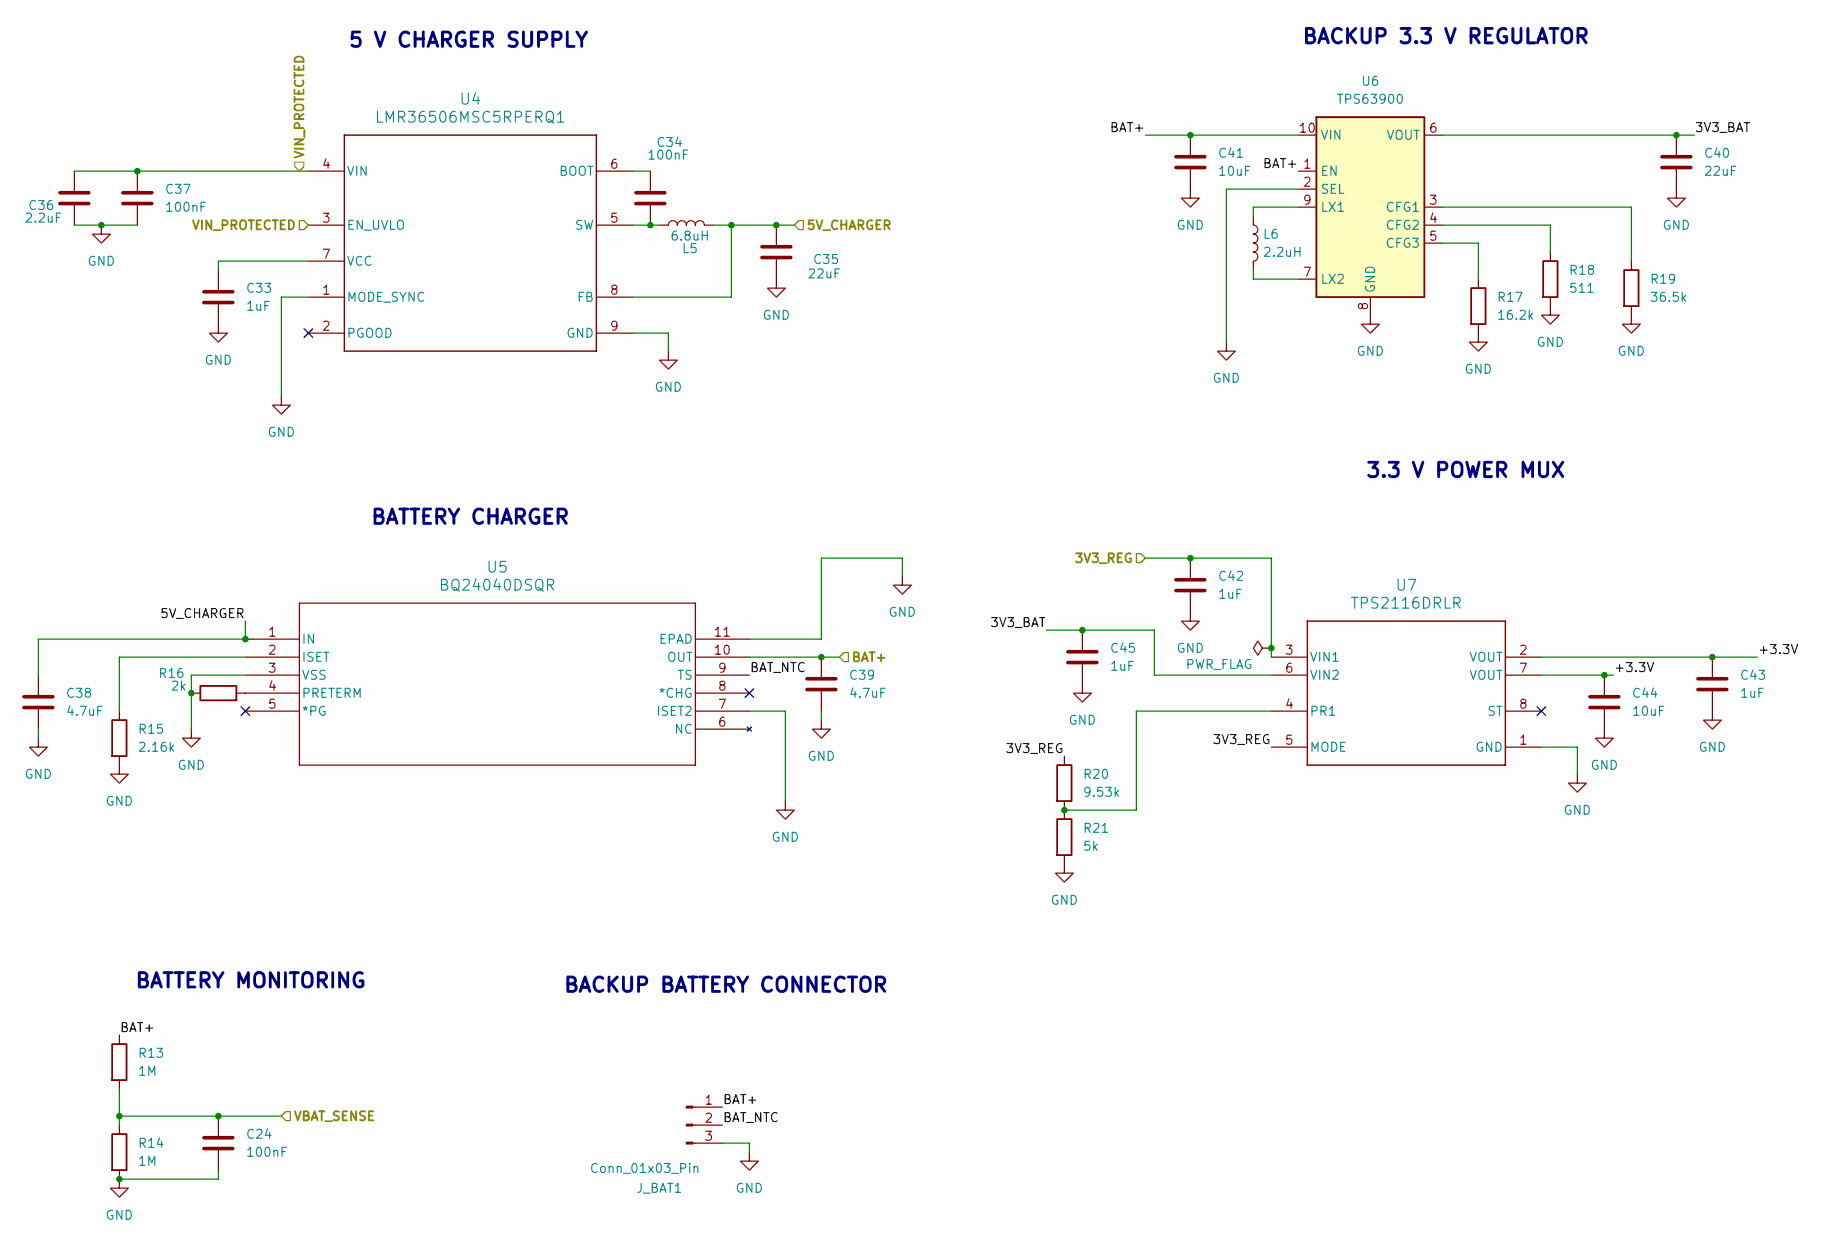
[picture p29: schematic 04_Battery.kicad_sch]

Parts:
C24: 100nF; C_0402_1005Metric
C33, C42, C43, C45: 1uF; C_0603_1608Metric
C34, C37: 100nF; C_0603_1608Metric
C35, C40: 22uF; C_0805_2012Metric
C36: 2.2uF; C_0805_2012Metric
C38, C39: 4.7uF; C_0805_2012Metric
C41, C44: 10uF; C_0805_2012Metric
J_BAT1: Conn_01x03_Pin; JST_PH_B3B-PH-K_1x03_P2.00mm_Vertical
L5: 6.8uH; L_Coilcraft_XxL4020
L6: 2.2uH; L_1008_2520Metric
R13, R14: 1M; R_0603_1608Metric
R15: 2.16k; R_0603_1608Metric
R16: 2k; R_0603_1608Metric
R17: 16.2k; R_0603_1608Metric
R18: 511; R_0603_1608Metric
R19: 36.5k; R_0603_1608Metric
R20: 9.53k; R_0603_1608Metric
R21: 5k; R_0603_1608Metric
U4: LMR36506MSC5RPERQ1; RPE0009A
U5: BQ24040DSQR; DSQ10_P9X1P5
U6: TPS63900; WSON-10-1EP_2.5x2.5mm_P0.5mm_EP1.2x2mm_ThermalVias
U7: TPS2116DRLR; DRL0008A-MFG

Connections:
/01_Power_Input/3V3_REG: C42.1, R20.1, U7.3 (VIN1), U7.5 (MODE); also elsewhere on the board
/01_Power_Input/VIN_PROTECTED: C36.1, C37.1, U4.3 (EN_UVLO), U4.4 (VIN); also elsewhere on the board
/02_BLE_MCU/VBAT_SENSE: C24.1, R13.2, R14.1; also elsewhere on the board
/04_Battery/3V3_BAT: C40.1, C45.1, U6.6 (VOUT), U7.6 (VIN2)
/04_Battery/5V_CHARGER: C35.1, C38.1, L5.2, U4.8 (FB), U5.1 (IN); also elsewhere on the board
/04_Battery/+3.3V: C43.1, C44.1, U7.2 (VOUT), U7.7 (VOUT)
/04_Battery/BAT+: C39.1, C41.1, J_BAT1.1, R13.1, U5.10 (OUT), U6.1 (EN), U6.10 (VIN); also elsewhere on the board
/04_Battery/BAT_NTC: J_BAT1.2, U5.9 (TS)
GND: C24.2, C33.2, C35.2, C36.2, C37.2, C38.2, C39.2, C40.2, C41.2, C42.2, C43.2, C44.2, C45.2, J_BAT1.3, R14.2, R15.2, R16.1, R17.2, R18.2, R19.2, R21.2, U4.1 (MODE_SYNC), U4.9 (GND), U5.3 (VSS), U5.7 (ISET2), U5.11 (EPAD), U6.2 (SEL), U6.8 (GND), U6.11 (GND), U7.1 (GND); also elsewhere on the board
unnamed: C34.1, U4.6 (BOOT)
unnamed: C34.2, L5.1, U4.5 (SW)
unnamed: C33.1, U4.7 (VCC)
unnamed: R15.1, U5.2 (ISET)
unnamed: R16.2, U5.4 (PRETERM)
unnamed: R19.1, U6.3 (CFG1)
unnamed: R18.1, U6.4 (CFG2)
unnamed: R17.1, U6.5 (CFG3)
unnamed: L6.1, U6.9 (LX1)
unnamed: L6.2, U6.7 (LX2)
unnamed: R20.2, R21.1, U7.4 (PR1)

Notes on the sheet:
3.3 V POWER MUX
BACKUP BATTERY CONNECTOR
BACKUP 3.3 V REGULATOR
BATTERY MONITORING
BATTERY CHARGER
5 V CHARGER SUPPLY

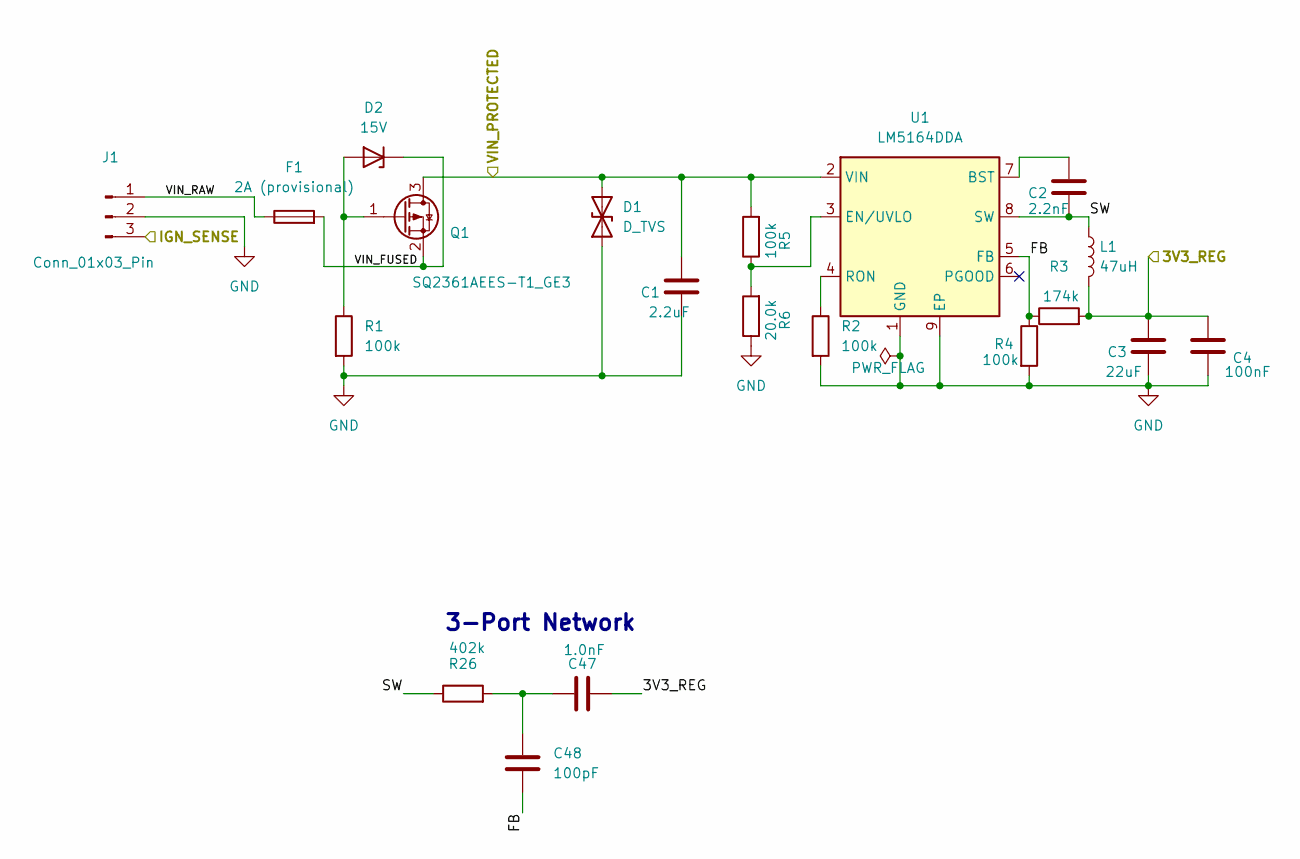
[picture p30: schematic 01_Power_Input.kicad_sch]

Parts:
C1: 2.2uF; C_0603_1608Metric
C2: 2.2nF; C_0603_1608Metric
C3: 22uF; C_0603_1608Metric
C4: 100nF; C_0603_1608Metric
C47: 1.0nF; C_0603_1608Metric
C48: 100pF; C_0402_1005Metric
D1: D_TVS; D_SMC
D2: 15V; D_SOD-123
F1: 2A (provisional); Fuse_1206_3216Metric
J1: Conn_01x03_Pin; PinHeader_1x03_P2.54mm_Vertical
L1: 47uH; L_Bourns_SRN6045TA
Q1: SQ2361AEES-T1_GE3; SOT-23
R1, R2, R4, R5: 100k; R_0603_1608Metric
R3: 174k; R_0603_1608Metric
R6: 20.0k; R_0603_1608Metric
R26: 402k; R_0603_1608Metric
U1: LM5164DDA; HSOP-8-1EP_3.9x4.9mm_P1.27mm_EP2.41x3.1mm_ThermalVias

Connections:
/01_Power_Input/3V3_REG: C3.1, C4.1, C47.2, L1.2, R3.2; also elsewhere on the board
/01_Power_Input/FB: C48.2, R3.1, R4.1, U1.5 (FB)
/01_Power_Input/IGN_SENSE: J1.3; also elsewhere on the board
/01_Power_Input/SW: C2.2, L1.1, R26.1, U1.8 (SW)
/01_Power_Input/VIN_FUSED: D2.1 (K), F1.2, Q1.2 (S)
/01_Power_Input/VIN_PROTECTED: C1.1, D1.2 (A2), Q1.3 (D), R5.2, U1.2 (VIN); also elsewhere on the board
/01_Power_Input/VIN_RAW: F1.1, J1.1
GND: C1.2, C3.2, C4.2, D1.1 (A1), J1.2, R1.2, R2.2, R4.2, R6.1, U1.1 (GND), U1.9 (EP); also elsewhere on the board
unnamed: C47.1, C48.1, R26.2
unnamed: D2.2 (A), Q1.1 (G), R1.1
unnamed: C2.1, U1.7 (BST)
unnamed: R5.1, R6.2, U1.3 (EN/UVLO)
unnamed: R2.1, U1.4 (RON)

Notes on the sheet:
3-Port Network

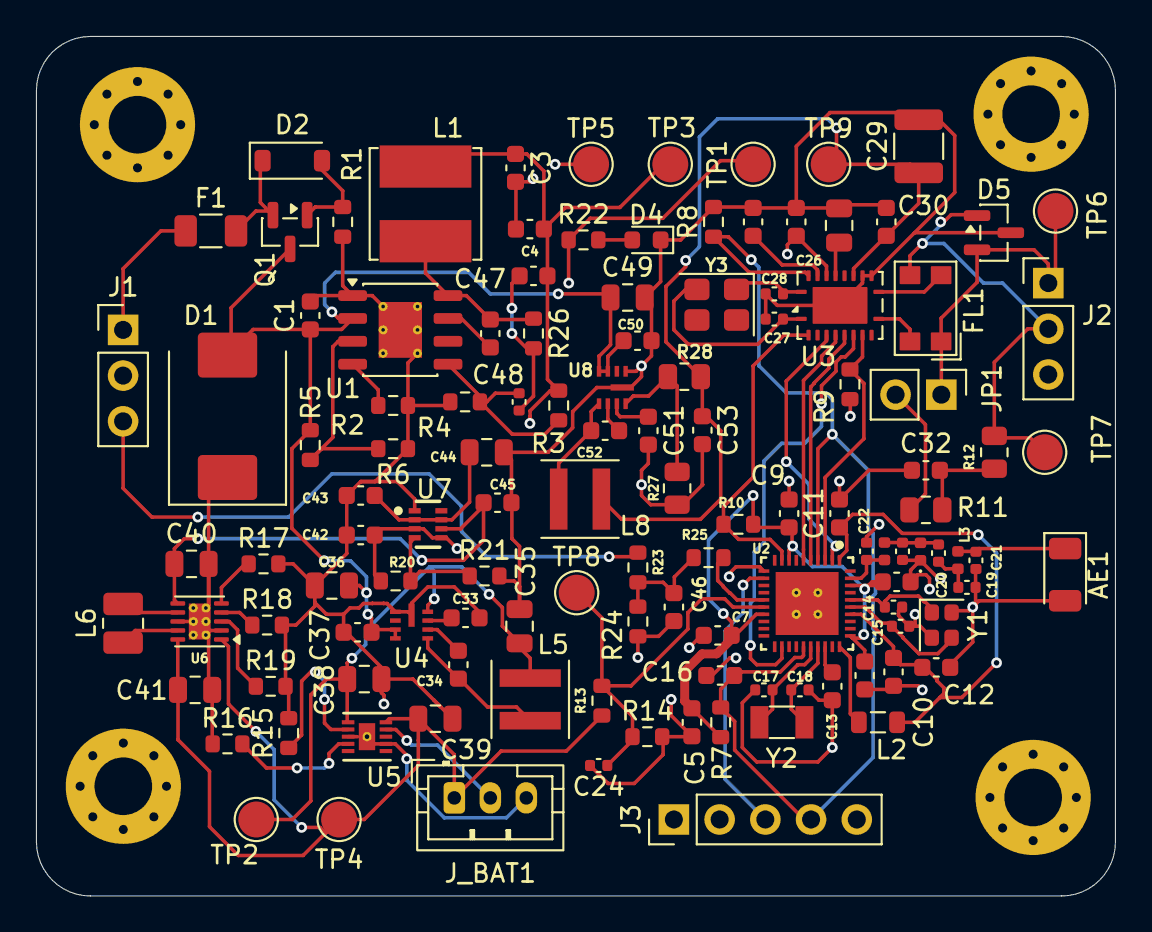
[picture p31: board Automotive_BLE_CAN.kicad_pcb from above]

Board: 4 copper layers, 59.9 x 47.8 mm, 122 parts (0 on the bottom side), 70 nets.
